Pixeljoch/Robocup_PCB/Robocup_PCB.csv

Id | Designator | Package | Quantity | Designation | Supplier and ref
1 | C1,C2,C3,C4,C5,C6,C7,C8,C9,C10,C11,C12 | C_1206_3216Metric_Pad1.42x1.75mm_HandSolder | 12 | 0.1uF
2 | C13 | C_1206_3216Metric_Pad1.42x1.75mm_HandSolder | 1 | 10n
3 | D1 | D_DO-201_P15.24mm_Horizontal | 1 | 1N5347B
4 | D2 | LED_0805_2012Metric_Pad1.15x1.40mm_HandSolder | 1 | GREEN
5 | D3 | LED_0805_2012Metric_Pad1.15x1.40mm_HandSolder | 1 | RED
6 | D4 | LED_0805_2012Metric_Pad1.15x1.40mm_HandSolder | 1 | BLUE
7 | IR1,IR2,IR3,IR4,IR5,IR6,IR7,IR8,IR9,IR10,IR11,IR12 | IR_TSOP93038_TH | 12 | TSSP93038
8 | J1 | PinSocket_1x06_P2.54mm_Vertical | 1 | M1_IN
9 | J2 | PinSocket_1x06_P2.54mm_Vertical | 1 | M2_IN
10 | J3 | PinSocket_1x06_P2.54mm_Vertical | 1 | M3_IN
11 | J4 | arduino_mega_header | 1 | Arduino_Mega_Header
12 | J8 | AMASS_XT60-M | 1 | XT60-M
13 | R1,R2,R3,R4,R5,R6,R7,R8,R9,R10,R11,R12 | R_1206_3216Metric_Pad1.42x1.75mm_HandSolder | 12 | 6k2
14 | R13 | R_1206_3216Metric_Pad1.42x1.75mm_HandSolder | 1 | 100k
15 | R14,R15 | R_1206_3216Metric_Pad1.42x1.75mm_HandSolder | 2 | 680R
16 | R16 | R_1206_3216Metric_Pad1.42x1.75mm_HandSolder | 1 | 180R
17 | SW_ARD,SW_M,SW_P | PinSocket_1x03_P2.54mm_Vertical | 3 | SS ESP101
18 | U1,U2,U5 | U_TB6612FNG_MOD | 3 | TB6612FNG_MOD
19 | U3 | 5V_D24V5F5_FP | 1 | 5V_D24V5F5
20 | U4 | 12_S18V20F12_FP | 1 | 12V_S18V20F12
21 | Q1 | TO-263-2 | 1 | IRF9540N
