Pixeljoch/Robocup_PCB/Main_Board/Main PCB outline.dxf

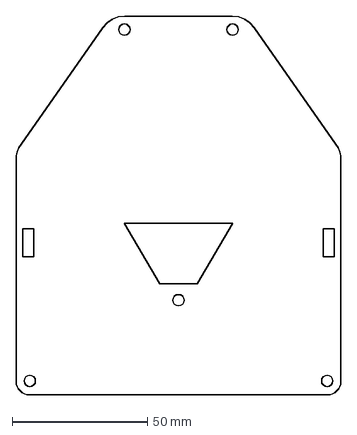
[picture p1: CAD file, 2022-02-05]
Main_Board/Main PCB outline.dxf
120.0 x 140.0 mm
