Pixeljoch/Robocup_PCB/3rd party libs/XT60-M.step

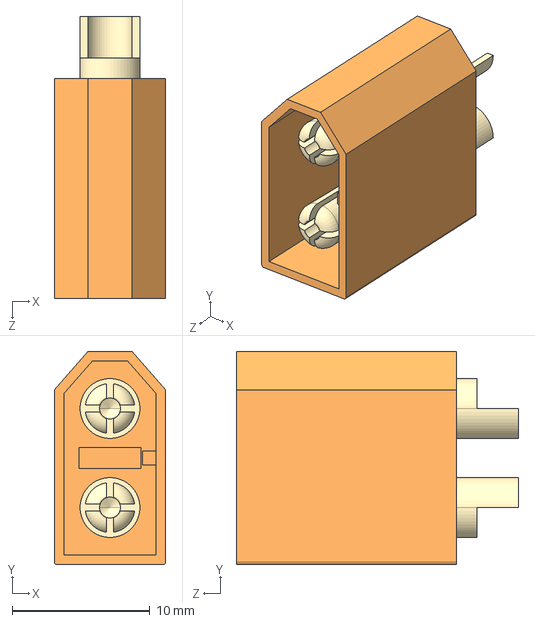
[picture p2: CAD file, 2021-01-07]
3rd party libs/XT60-M.step
8.10 x 15.5 x 20.5 mm
