Pixeljoch/Robocup_PCB/IR_Board/IR_Board.step

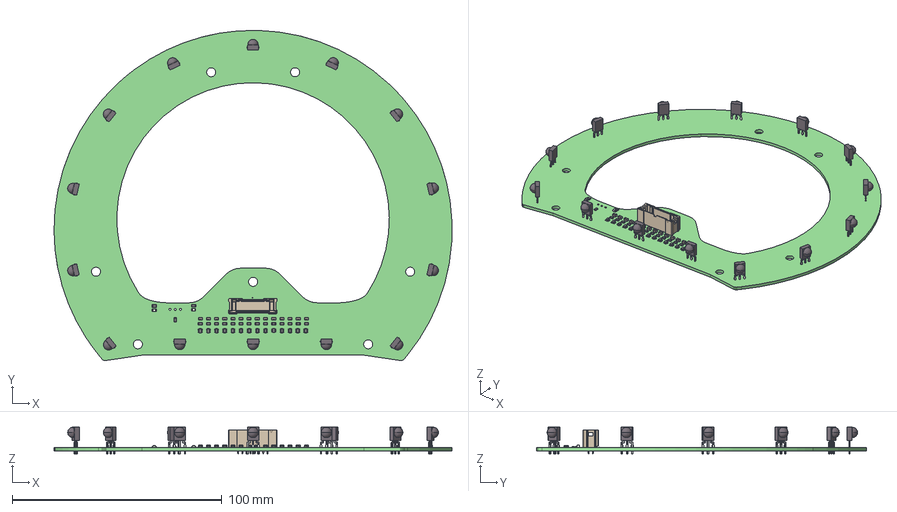
[picture p3: CAD file, 2022-02-22]
IR_Board/IR_Board.step
189.9 x 157.5 x 12.8 mm
IR_Board PCB
