Pixeljoch/Robocup_PCB/Light_Ring_PCB/Light_Ring_PCB.step

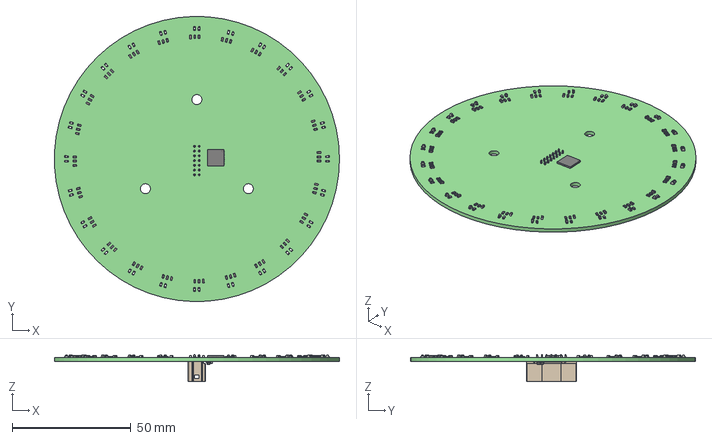
[picture p4: CAD file, 2022-02-01]
Light_Ring_PCB/Light_Ring_PCB.step
119.9 x 120.0 x 11.4 mm
