Pixeljoch/Robocup_PCB/sciencelab_logo.dxf

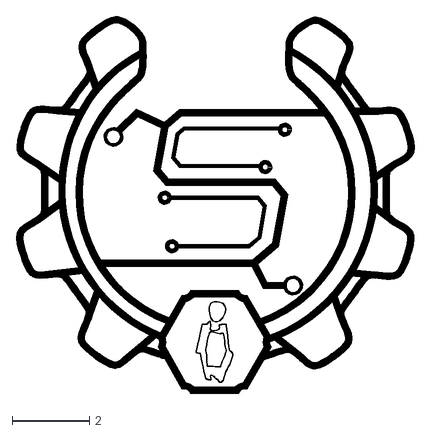
[picture p5: CAD file, 2022-01-30]
sciencelab_logo.dxf
10.3 x 9.77
