Pixeljoch/Robocup_PCB/3rd party libs/IRFR120ZTRPBF.step

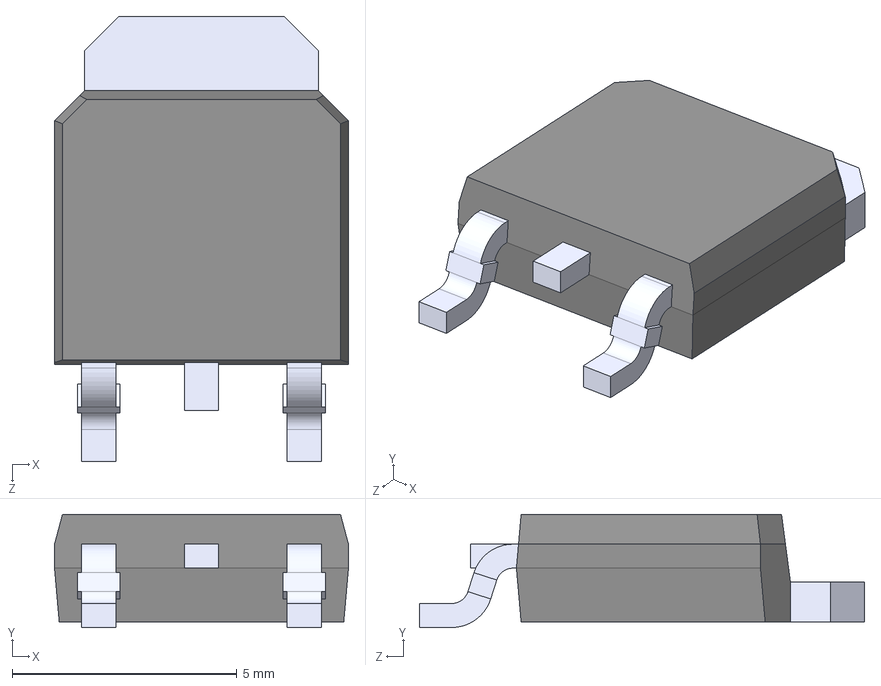
[picture p6: CAD file, 2021-01-07]
3rd party libs/IRFR120ZTRPBF.step
6.54 x 2.51 x 9.91 mm
