Pixeljoch/Robocup_PCB/IR_Board/IR PCB outline final.dxf

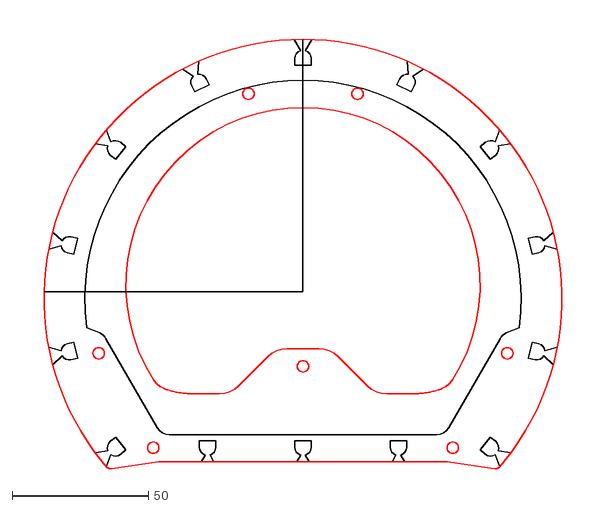
[picture p7: CAD file, 2022-02-11]
IR_Board/IR PCB outline final.dxf
210.4 x 166.1
