Pixeljoch/Robocup_PCB/Light_Ring_PCB/LightPCB outline.dxf

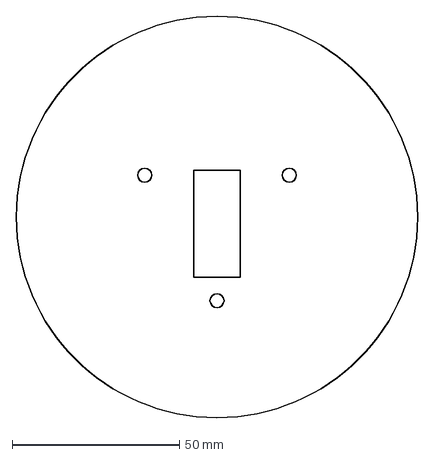
[picture p8: CAD file, 2022-01-28]
Light_Ring_PCB/LightPCB outline.dxf
120.0 x 120.0 mm
