Pixeljoch/Robocup_PCB/Light_Ring_PCB/voetbalrobotnieuwplaatv19.dxf

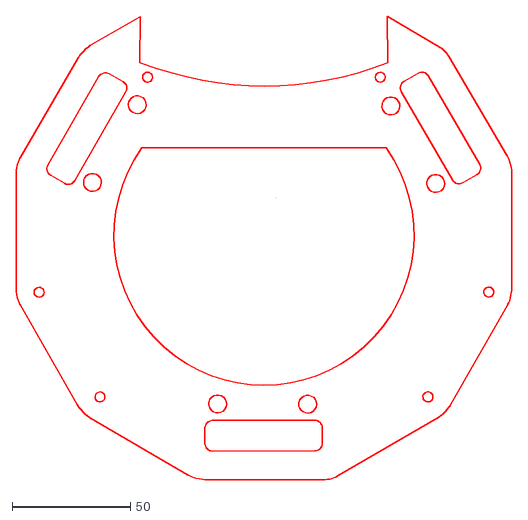
[picture p9: CAD file, 2021-04-22]
Light_Ring_PCB/voetbalrobotnieuwplaatv19.dxf
209.7 x 196.1
