Pixeljoch/Robocup_PCB/Light_Ring_PCB/Light_Ring_PCB.pdf

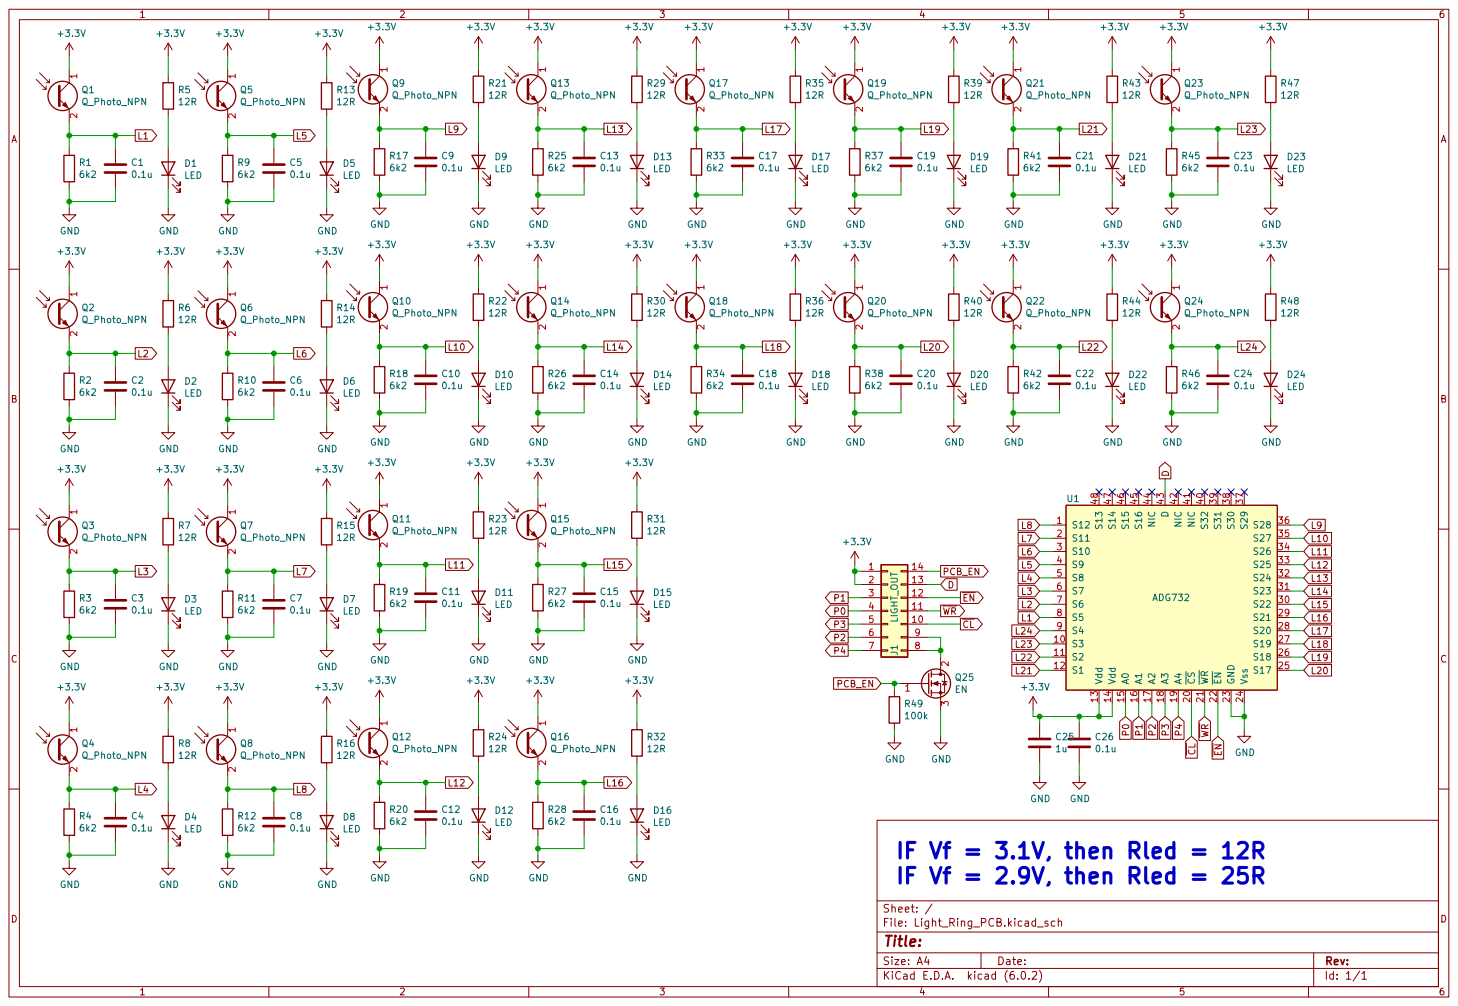
[picture p10: page 1]

IF Vf = 2.9V, then Rled = 25R
