Pixeljoch/Robocup_PCB/Main_Board/Main_Board.pdf

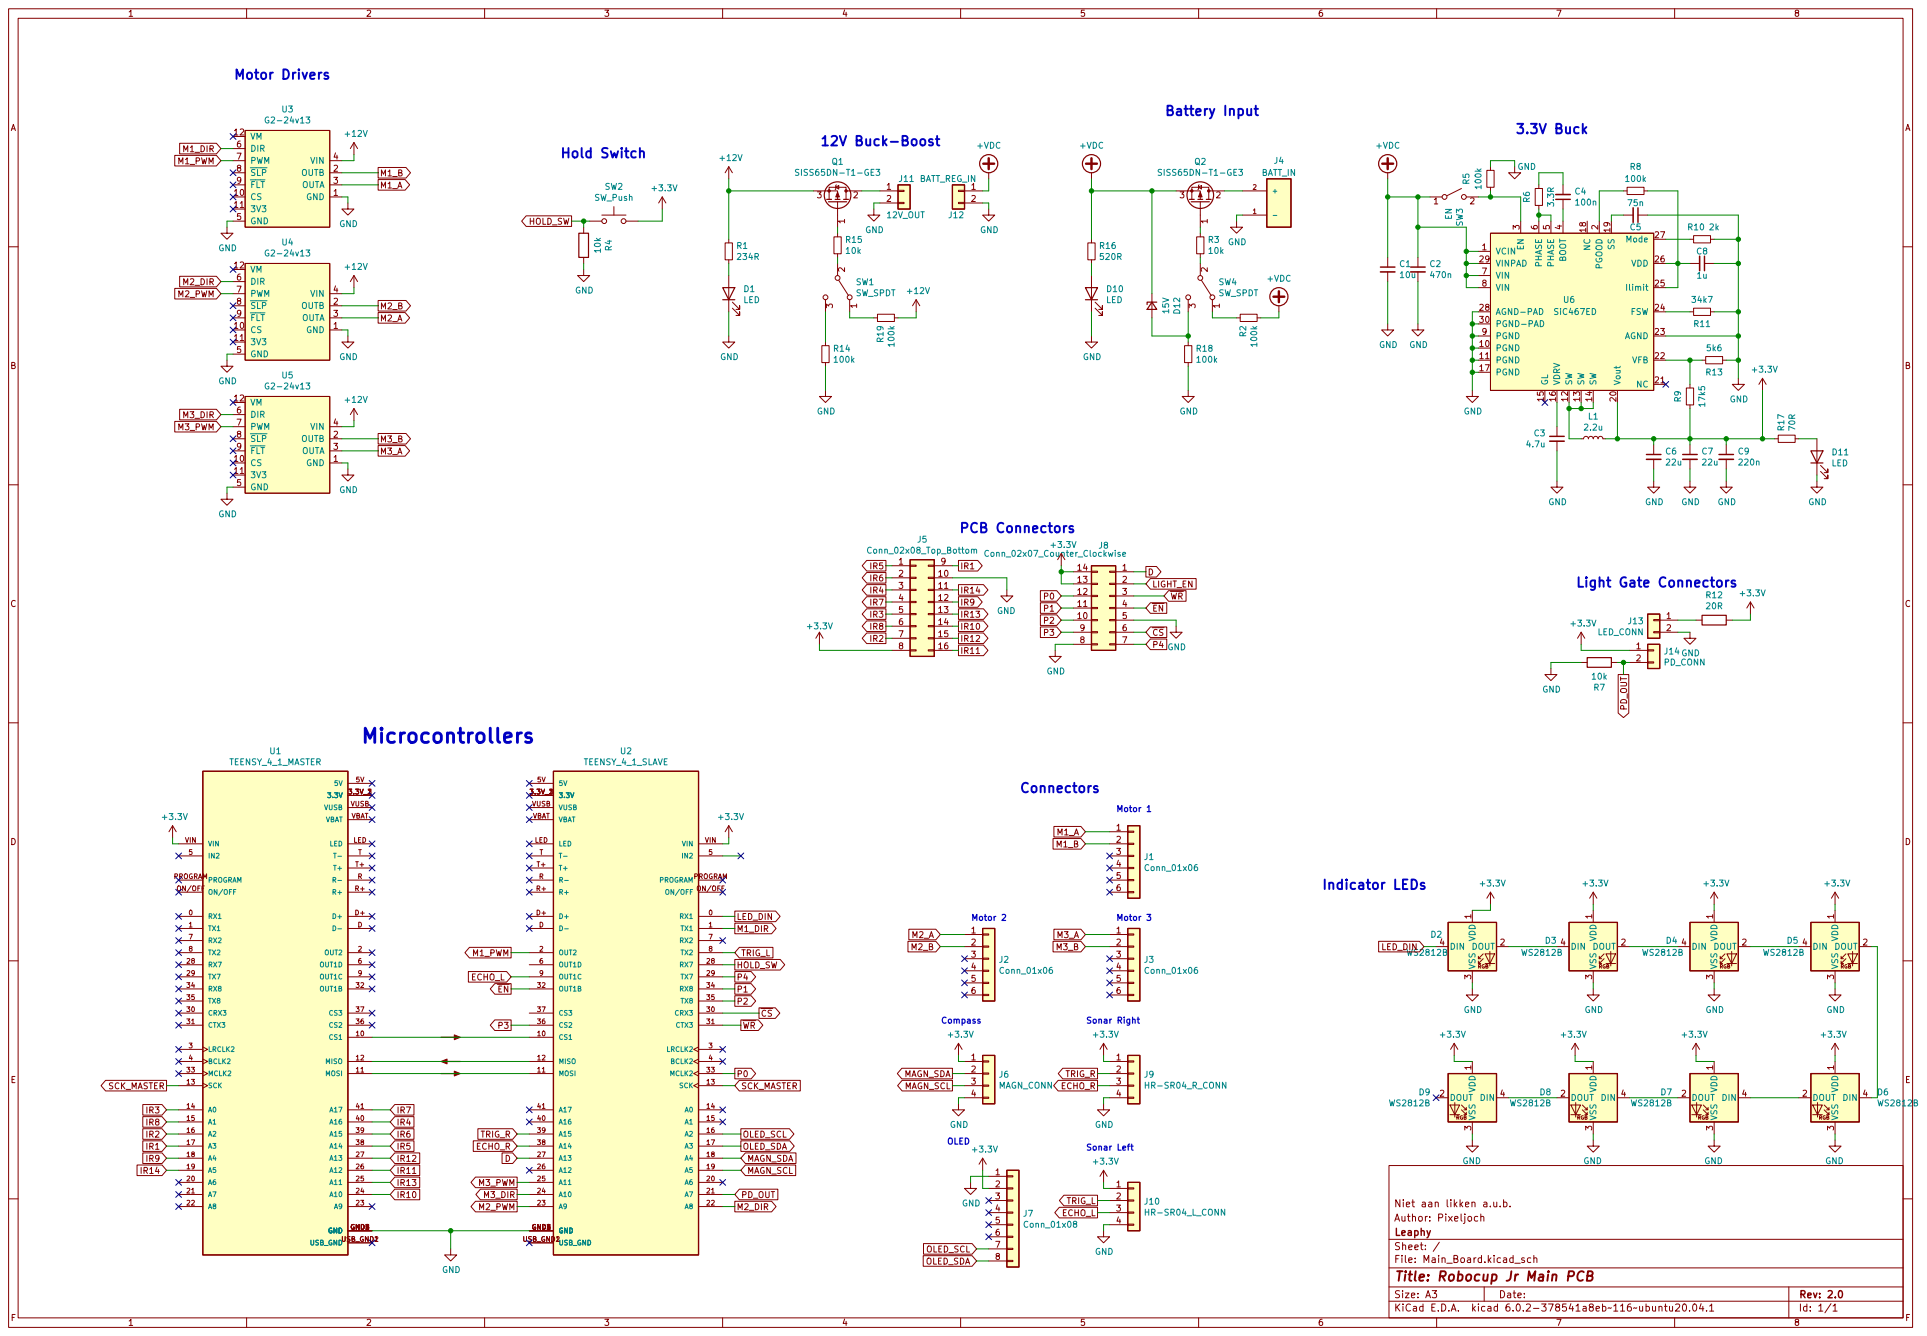
[picture p11: page 1]

Id: 1/1 Title: Robocup Jr Main PCB
