Pixeljoch/Robocup_PCB/IR_Board/IR_Board.kicad_pcb

## KiCad design IR_Board/IR_Board.kicad_pcb (2022-02-22)

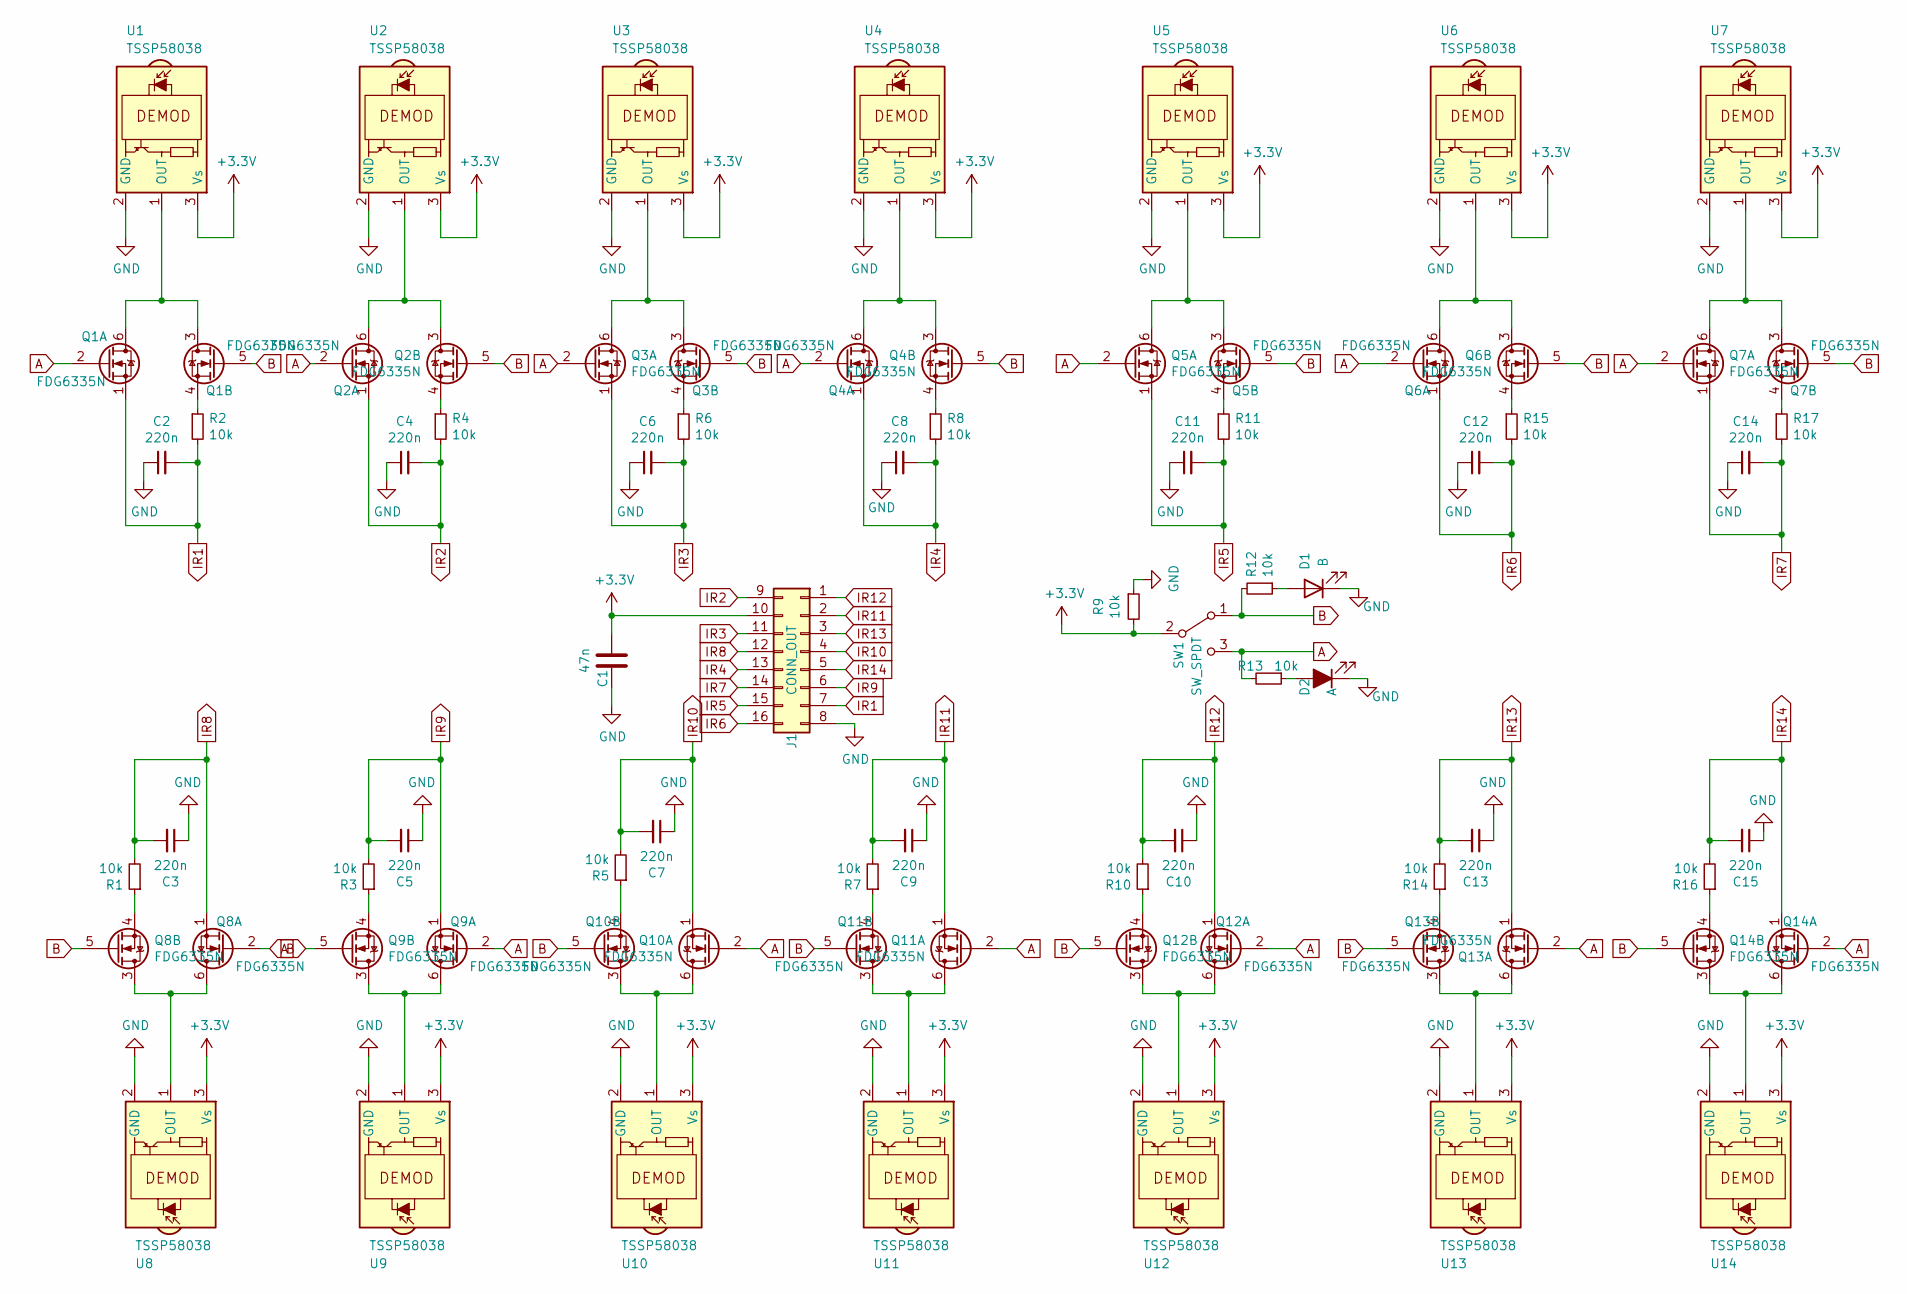
[picture p12: schematic IR_Board.kicad_sch, IR PCB Goaly]

Parts:
C1: 47n; C_0201_0603Metric
C2, C3, C4, C5, C6, C7, C8, C9, C10, C11, C12, C13, C14, C15: 220n; C_0805_2012Metric_Pad1.18x1.45mm_HandSolder
D1: B; LED_0805_2012Metric_Pad1.15x1.40mm_HandSolder
D2: A; LED_0805_2012Metric_Pad1.15x1.40mm_HandSolder
J1: CONN_OUT; Hirose_DF11-16DP-2DSA_2x08_P2.00mm_Vertical
Q1, Q2, Q3, Q4, Q5, Q6, Q7, Q8, Q9, Q10, Q11, Q12, Q13, Q14: FDG6335N; SOT-363_SC-70-6
R1, R2, R3, R4, R5, R6, R7, R8, R9, R10, R11, R12, R13, R14, R15, R16, R17: 10k; R_0805_2012Metric_Pad1.20x1.40mm_HandSolder
SW1: SW_SPDT; EG1218
U1, U2, U3, U4, U5, U6, U7, U8, U9, U10, U11, U12, U13, U14: TSSP58038; Vishay_MINIMOLD-3Pin

Connections:
+3V3: C1.2, J1.10, R9.2, SW1.2 (B), U1.3 (Vs), U2.3 (Vs), U3.3 (Vs), U4.3 (Vs), U5.3 (Vs), U6.3 (Vs), U7.3 (Vs), U8.3 (Vs), U9.3 (Vs), U10.3 (Vs), U11.3 (Vs), U12.3 (Vs), U13.3 (Vs), U14.3 (Vs)
A: Q1.2 (G), Q2.2 (G), Q3.2 (G), Q4.2 (G), Q5.2 (G), Q6.2 (G), Q7.2 (G), Q8.2 (G), Q9.2 (G), Q10.2 (G), Q11.2 (G), Q12.2 (G), Q13.2 (G), Q14.2 (G), R13.2, SW1.3 (C)
B: Q1.5 (G), Q2.5 (G), Q3.5 (G), Q4.5 (G), Q5.5 (G), Q6.5 (G), Q7.5 (G), Q8.5 (G), Q9.5 (G), Q10.5 (G), Q11.5 (G), Q12.5 (G), Q13.5 (G), Q14.5 (G), R12.2, SW1.1 (A)
GND: C1.1, C2.1, C3.1, C4.1, C5.1, C6.1, C7.1, C8.1, C9.1, C10.1, C11.1, C12.1, C13.1, C14.1, C15.1, D1.1 (K), D2.1 (K), J1.8, R9.1, U1.2 (GND), U2.2 (GND), U3.2 (GND), U4.2 (GND), U5.2 (GND), U6.2 (GND), U7.2 (GND), U8.2 (GND), U9.2 (GND), U10.2 (GND), U11.2 (GND), U12.2 (GND), U13.2 (GND), U14.2 (GND)
IR1: C2.2, J1.7, Q1.1 (S), R2.2
IR2: C4.2, J1.9, Q2.1 (S), R4.2
IR3: C6.2, J1.11, Q3.1 (S), R6.2
IR4: C8.2, J1.13, Q4.1 (S), R8.2
IR5: C11.2, J1.15, Q5.1 (S), R11.2
IR6: C12.2, J1.16, Q6.1 (S), R15.2
IR7: C14.2, J1.14, Q7.1 (S), R17.2
IR8: C3.2, J1.12, Q8.1 (S), R1.2
IR9: C5.2, J1.6, Q9.1 (S), R3.2
IR10: C7.2, J1.4, Q10.1 (S), R5.2
IR11: C9.2, J1.2, Q11.1 (S), R7.2
IR12: C10.2, J1.1, Q12.1 (S), R10.2
IR13: C13.2, J1.3, Q13.1 (S), R14.2
IR14: C15.2, J1.5, Q14.1 (S), R16.2
unnamed: D1.2 (A), R12.1
unnamed: D2.2 (A), R13.1
unnamed: Q1.3 (D), Q1.6 (D), U1.1 (OUT)
unnamed: Q1.4 (S), R2.1
unnamed: Q2.3 (D), Q2.6 (D), U2.1 (OUT)
unnamed: Q2.4 (S), R4.1
unnamed: Q3.3 (D), Q3.6 (D), U3.1 (OUT)
unnamed: Q3.4 (S), R6.1
unnamed: Q4.3 (D), Q4.6 (D), U4.1 (OUT)
unnamed: Q4.4 (S), R8.1
unnamed: Q5.3 (D), Q5.6 (D), U5.1 (OUT)
unnamed: Q5.4 (S), R11.1
unnamed: Q6.3 (D), Q6.6 (D), U6.1 (OUT)
unnamed: Q6.4 (S), R15.1
unnamed: Q7.3 (D), Q7.6 (D), U7.1 (OUT)
unnamed: Q7.4 (S), R17.1
unnamed: Q8.3 (D), Q8.6 (D), U8.1 (OUT)
unnamed: Q8.4 (S), R1.1
unnamed: Q9.3 (D), Q9.6 (D), U9.1 (OUT)
unnamed: Q9.4 (S), R3.1
unnamed: Q10.3 (D), Q10.6 (D), U10.1 (OUT)
unnamed: Q10.4 (S), R5.1
unnamed: Q11.3 (D), Q11.6 (D), U11.1 (OUT)
unnamed: Q11.4 (S), R7.1
unnamed: Q12.3 (D), Q12.6 (D), U12.1 (OUT)
unnamed: Q12.4 (S), R10.1
unnamed: Q13.3 (D), Q13.6 (D), U13.1 (OUT)
unnamed: Q13.4 (S), R14.1
unnamed: Q14.3 (D), Q14.6 (D), U14.1 (OUT)
unnamed: Q14.4 (S), R16.1

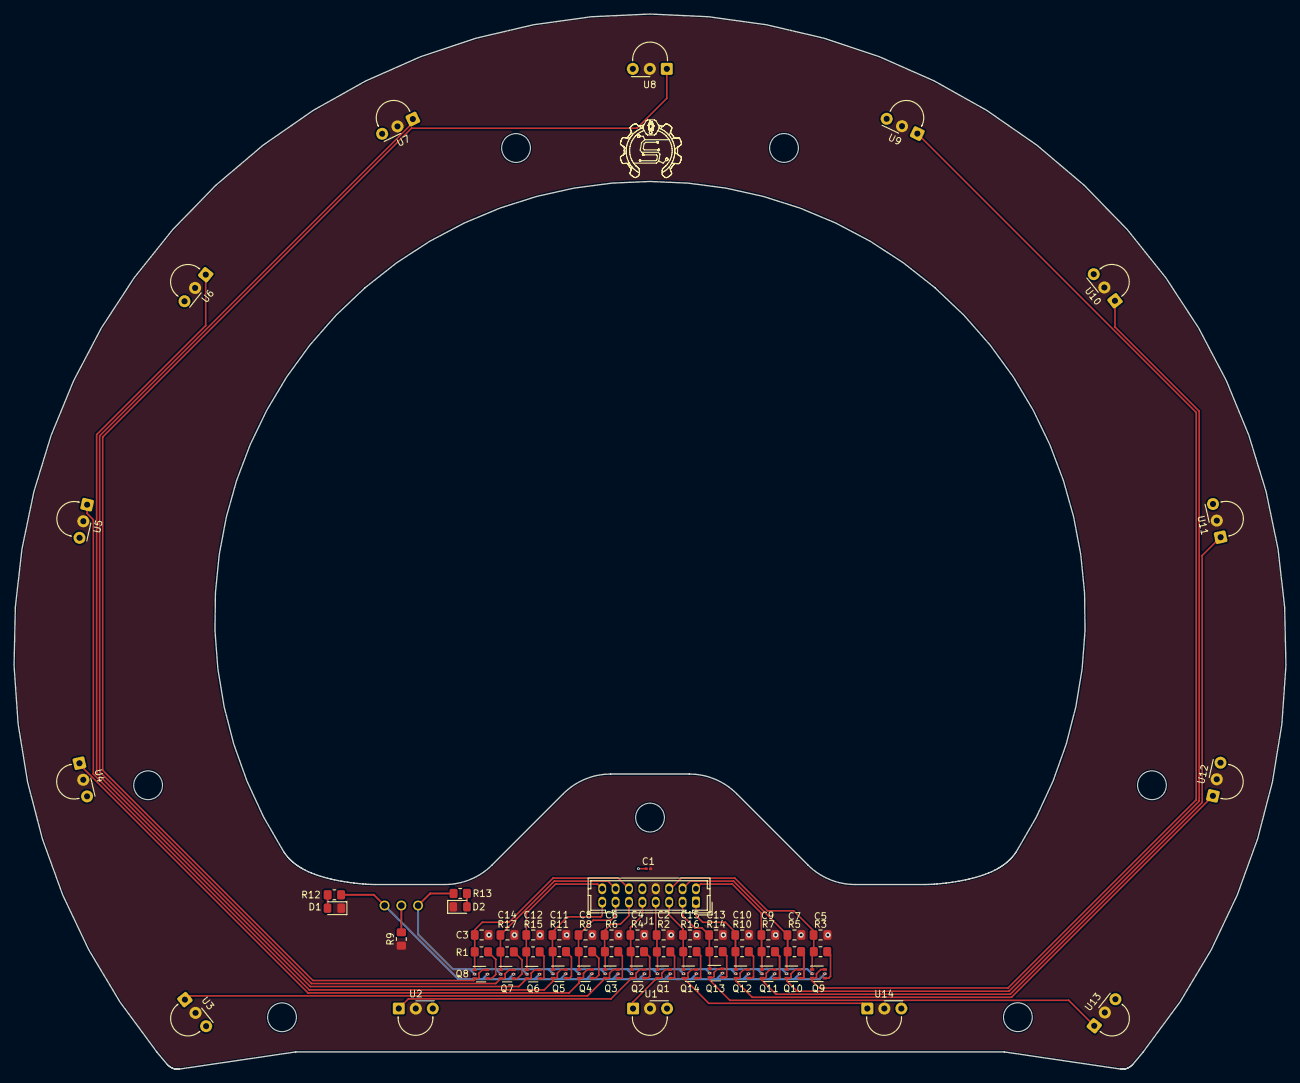
[picture p13: board IR_Board.kicad_pcb from above]

Board: 2 copper layers, 189.9 x 157.6 mm, 65 parts (1 on the bottom side), 48 nets.

Other parts of the board:
MH: MountingHole_4.3mm_M4
