Pixeljoch/Robocup_PCB/Main_Board/Main_Board.kicad_pcb

## KiCad design Main_Board/Main_Board.kicad_pcb (2022-02-16)

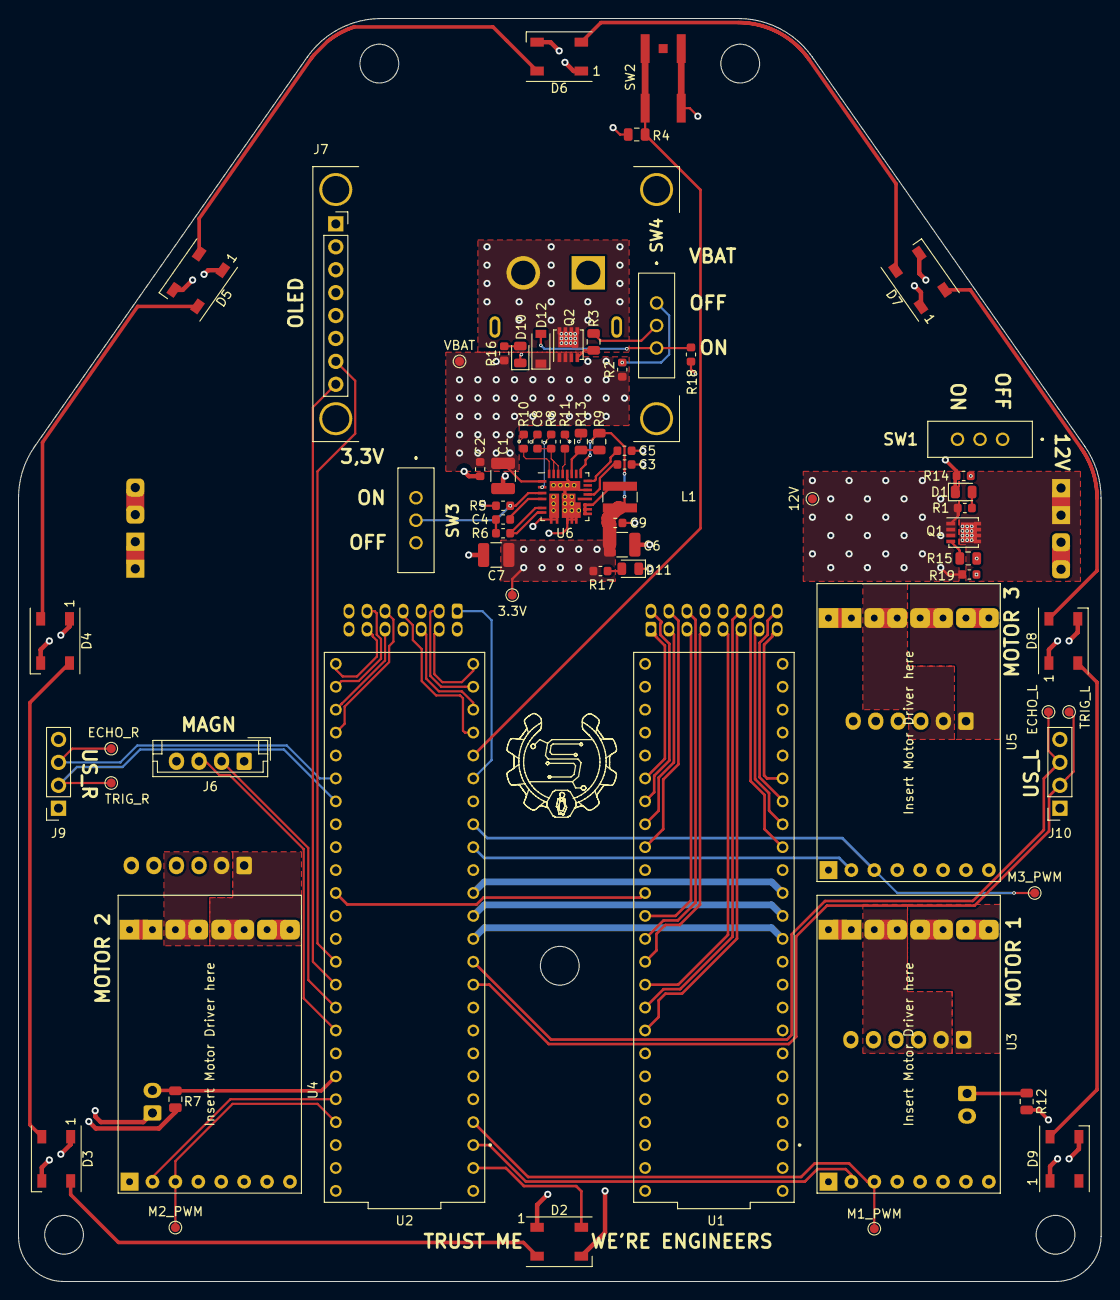
[picture p14: board Main_Board.kicad_pcb from above]

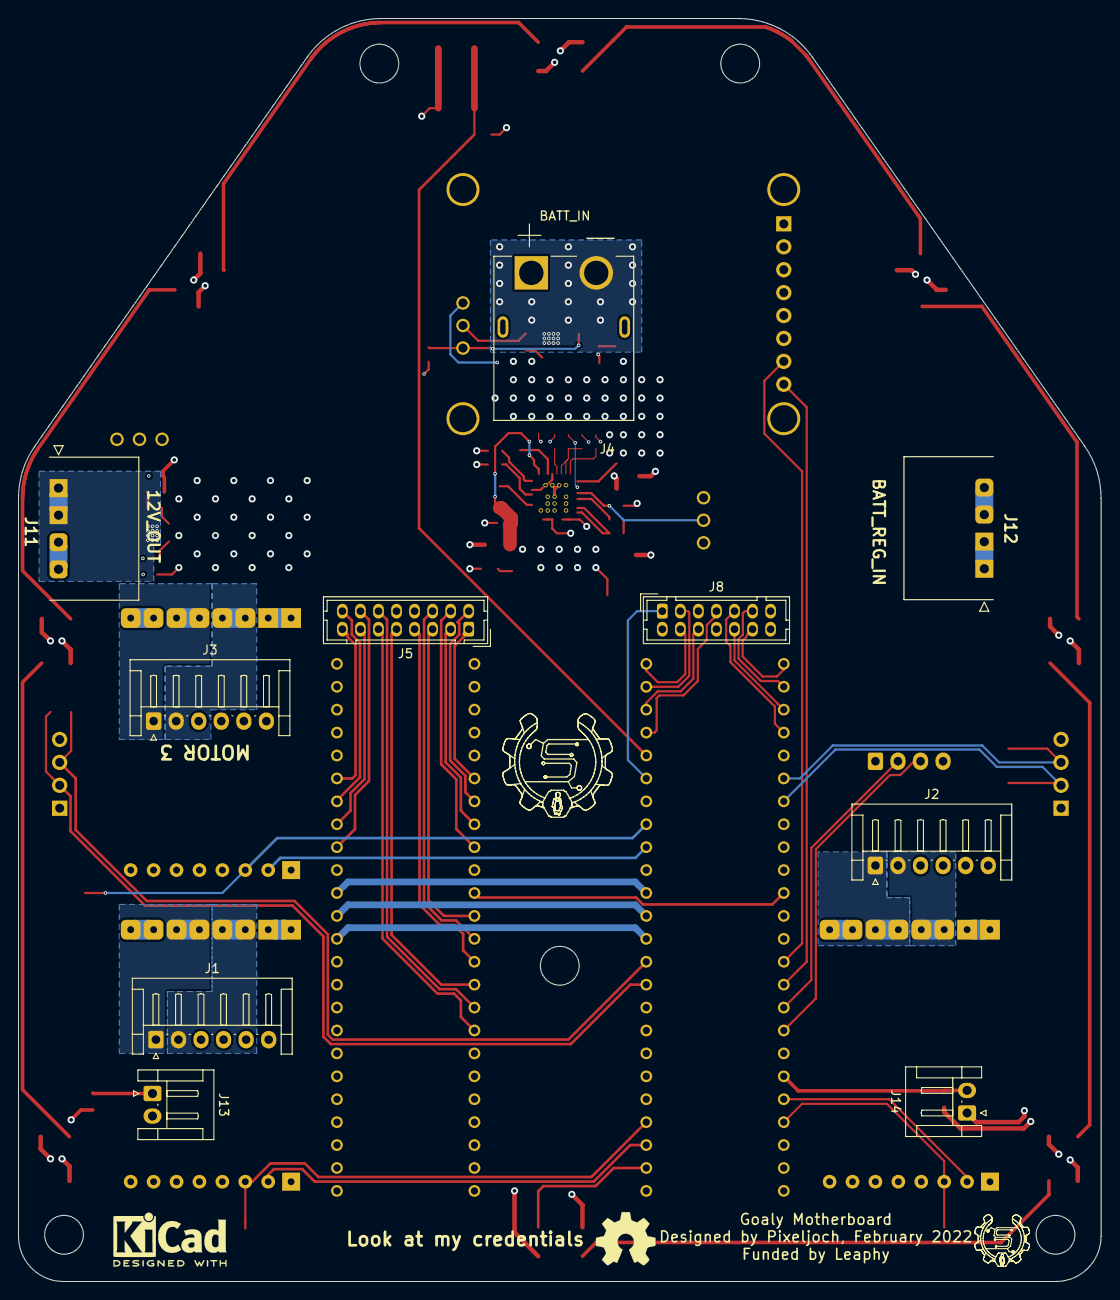
[picture p15: board Main_Board.kicad_pcb from below]

Board: 4 copper layers, 120.0 x 140.0 mm, 79 parts (10 on the bottom side), 87 nets.

Parts:
3.3V, 12V: TestPoint_Pad_D1.0mm
C1: 10u; C_1210_3225Metric
C2: 470n; C_0603_1608Metric
C3: 4.7u; C_0603_1608Metric
C4: 100n; C_0603_1608Metric
C5: 75n; C_0603_1608Metric
C6, C7: 22u; C_1210_3225Metric
C8: 1u; C_0603_1608Metric
C9: 220n; C_0603_1608Metric
D1, D10, D11: LED; LED_0805_2012Metric
D2, D3, D4, D5, D6, D7, D8, D9: WS2812B; LED_WS2812B_PLCC4_5.0x5.0mm_P3.2mm
D12: 20V; D_SOD-123
ECHO_L: TestPoint_Pad_D1.0mm
ECHO_R: TestPoint_Pad_D1.0mm
J1, J2, J3: Conn_01x06; JST_EH_S6B-EH_1x06_P2.50mm_Horizontal
J4: BATT_IN; AMASS_XT60PW-M
J5: Conn_02x08_Top_Bottom; Hirose_DF11-16DP-2DSA_2x08_P2.00mm_Vertical
J6: MAGN_CONN; JST_EH_B4B-EH-A_1x04_P2.50mm_Vertical
J7: Conn_01x08; PinSocket_1x08_P2.54mm_Vertical
J8: Conn_02x07_Counter_Clockwise; Hirose_DF11-14DP-2DSA_2x07_P2.00mm_Vertical
J9: HR-SR04_R_CONN; PinSocket_1x04_P2.54mm_Vertical
J10: HR-SR04_L_CONN; PinSocket_1x04_P2.54mm_Vertical
J11: 12V_OUT; 215760-YY04
J12: BATT_REG_IN; 215760-YY04
J13: LED_CONN; JST_EH_S2B-EH_1x02_P2.50mm_Horizontal
J14: PD_CONN; JST_EH_S2B-EH_1x02_P2.50mm_Horizontal
L1: 2.2u; Bours_SRP4020FA
M1_PWM, M2_PWM, M3_PWM: TestPoint_Pad_D1.0mm
M4, M4#2: MountingHole_4.3mm_M4
Q1, Q2: SISS65DN-T1-GE3; Vishay_PowerPAK_1212-8_Single
R1: 234R; R_0603_1608Metric
R2, R5, R8, R14, R18, R19: 100k; R_0603_1608Metric
R3, R4, R7, R15: 10k; R_0805_2012Metric
R6: 3.3R; R_0603_1608Metric
R9: 17k5; R_0805_2012Metric
R10: 2k; R_0603_1608Metric
R11: 34k7; R_0603_1608Metric
R12: 20R; R_0805_2012Metric
R13: 5k6; R_0805_2012Metric
R16: 520R; R_0603_1608Metric
R17: 70R; R_0603_1608Metric
SW1, SW4: SW_SPDT; EG1218
SW2: SW_Push; EVP-BT2J4A000
SW3: EN; EG1218
TRIG_L: TestPoint_Pad_D1.0mm
TRIG_R: TestPoint_Pad_D1.0mm
U1: TEENSY_4_1_MASTER; TEENSY_4_1_FP
U2: TEENSY_4_1_SLAVE; TEENSY_4_1_FP
U3, U4, U5: G2-24v13
U6: SiC467ED; Vishay_PowerPAK_MLP55-27L_ThermalVias
VBAT: TestPoint_Pad_D1.0mm

Connections:
+3V3: 3.3V.1, C6.1, C7.1, C9.1, D2.1 (VDD), D3.1 (VDD), D4.1 (VDD), D5.1 (VDD), D6.1 (VDD), D7.1 (VDD), D8.1 (VDD), D9.1 (VDD), J5.8, J6.1, J7.2, J8.13, J8.14, J9.1, J10.1, J14.1, L1.2, R9.1, R12.2, R17.1, SW2.2, U1.VIN, U2.VIN, U6.20 (Vout)
+12V: Q1.3 (S), R1.1, R19.2, U3.4 (VIN), U4.4 (VIN), U5.4 (VIN)
+VDC: C1.1, C2.1, D12.1 (K), J12.1, Q2.3 (S), R2.2, R16.1, SW3.1 (A), U6.1 (VCIN), U6.7 (VIN), U6.8 (VIN), U6.29 (VINPAD), VBAT.1
D: J8.1, U2.27 (A13)
ECHO_L: ECHO_L.1, J10.3, U2.9 (OUT1C)
ECHO_R: ECHO_R.1, J9.3, U2.38 (A14)
GND: C1.2, C2.2, C3.2, C5.1, C6.2, C7.2, C8.1, C9.2, D1.1 (K), D2.3 (VSS), D3.3 (VSS), D4.3 (VSS), D5.3 (VSS), D6.3 (VSS), D7.3 (VSS), D8.3 (VSS), D9.3 (VSS), D10.1 (K), D11.1 (K), J4.1 (-), J5.10, J6.4, J7.1, J8.5, J8.8, J9.4, J10.4, J11.2, J12.2, J13.2, R4.1, R5.2, R7.1, R10.1, R11.1, R13.1, R14.2, R18.2, U1.GND1 (GND), U1.GND2 (GND), U1.GND3 (GND), U2.GND1 (GND), U2.GND2 (GND), U2.GND3 (GND), U3.1 (GND), U3.5 (GND), U4.1 (GND), U4.5 (GND), U5.1 (GND), U5.5 (GND), U6.9 (PGND), U6.10 (PGND), U6.11 (PGND), U6.17 (PGND), U6.23 (AGND), U6.28 (AGND-PAD), U6.30 (PGND-PAD)
HOLD_SW: R4.2, SW2.1, U2.28 (RX7)
IR1: J5.9, U1.17 (A3)
IR2: J5.7, U1.16 (A2)
IR3: J5.5, U1.14 (A0)
IR4: J5.3, U1.40 (A16)
IR5: J5.1, U1.38 (A14)
IR6: J5.2, U1.39 (A15)
IR7: J5.4, U1.41 (A17)
IR8: J5.6, U1.15 (A1)
IR9: J5.12, U1.18 (A4)
IR10: J5.14, U1.24 (A10)
IR11: J5.16, U1.26 (A12)
IR12: J5.15, U1.27 (A13)
IR13: J5.13, U1.25 (A11)
IR14: J5.11, U1.19 (A5)
LED_DIN: D2.4 (DIN), U2.0 (RX1)
M1_A: J1.1, U3.3 (OUTA)
M1_B: J1.2, U3.2 (OUTB)
M1_DIR: U2.1 (TX1), U3.6 (DIR)
M1_PWM: M1_PWM.1, U2.2 (OUT2), U3.7 (PWM)
M2_A: J2.1, U4.3 (OUTA)
M2_B: J2.2, U4.2 (OUTB)
M2_DIR: U2.22 (A8), U4.6 (DIR)
M2_PWM: M2_PWM.1, U2.23 (A9), U4.7 (PWM)
M3_A: J3.1, U5.3 (OUTA)
M3_B: J3.2, U5.2 (OUTB)
M3_DIR: U2.24 (A10), U5.6 (DIR)
M3_PWM: M3_PWM.1, U2.25 (A11), U5.7 (PWM)
MAGN_SCL: J6.3, U2.19 (A5)
MAGN_SDA: J6.2, U2.18 (A4)
unnamed: C3.1, U6.16 (VDRV)
unnamed: C4.1, U6.4 (BOOT)
unnamed: C4.2, R6.2
unnamed: C5.2, U6.19 (SS)
unnamed: C8.2, R8.1, U6.25 (Ilimit), U6.26 (VDD)
unnamed: D1.2 (A), R1.2
unnamed: D2.2 (DOUT), D3.4 (DIN)
unnamed: D3.2 (DOUT), D4.4 (DIN)
unnamed: D4.2 (DOUT), D5.4 (DIN)
unnamed: D5.2 (DOUT), D6.4 (DIN)
unnamed: D6.2 (DOUT), D7.4 (DIN)
unnamed: D7.2 (DOUT), D8.4 (DIN)
unnamed: D8.2 (DOUT), D9.4 (DIN)
unnamed: D10.2 (A), R16.2
unnamed: D11.2 (A), R17.2
unnamed: D12.2 (A), R18.1, SW4.3 (C)
unnamed: J4.2 (+), Q2.2 (D)
unnamed: J11.1, Q1.2 (D)
unnamed: J13.1, R12.1
unnamed: L1.1, U6.12 (SW), U6.13 (SW), U6.14 (SW)
unnamed: Q1.1 (G), R15.1
unnamed: Q2.1 (G), R3.1
unnamed: R2.1, SW4.1 (A)
unnamed: R3.2, SW4.2 (B)
unnamed: R5.1, SW3.2 (B), U6.3 (EN)
unnamed: R6.1, U6.5 (PHASE), U6.6 (PHASE)
unnamed: R8.2, U6.2 (PGOOD)
unnamed: R10.2, U6.27 (Mode)
unnamed: R11.2, U6.24 (FSW)
unnamed: R9.2, R13.2, U6.22 (VFB)
unnamed: R14.1, SW1.3 (C)
unnamed: R15.2, SW1.2 (B)
unnamed: R19.1, SW1.1 (A)
unnamed: U1.10 (CS1), U2.10 (CS1)
unnamed: U1.11 (MOSI), U2.11 (MOSI)
unnamed: U1.12 (MISO), U2.12 (MISO)
OLED_SCL: J7.7, U2.16 (A2)
OLED_SDA: J7.8, U2.17 (A3)
P0: J8.12, U2.33 (MCLK2)
P1: J8.11, U2.34 (RX8)
P2: J8.10, U2.35 (TX8)
P3: J8.9, U2.36 (CS2)
P4: J8.7, U2.29 (TX7)
PD_OUT: J14.2, R7.2, U2.21 (A7)
SCK_MASTER: U1.13 (SCK), U2.13 (SCK)
TRIG_L: J10.2, TRIG_L.1, U2.8 (TX2)
TRIG_R: J9.2, TRIG_R.1, U2.39 (A15)
~CS: J8.6, U2.30 (CRX3)
~EN: J8.4, U2.32 (OUT1B)
~WR: J8.3, U2.31 (CTX3)
