Pixeljoch/Robocup_PCB/Light_Ring_PCB/Light_Ring_PCB.kicad_pcb

## KiCad design Light_Ring_PCB/Light_Ring_PCB.kicad_pcb (2022-02-13)

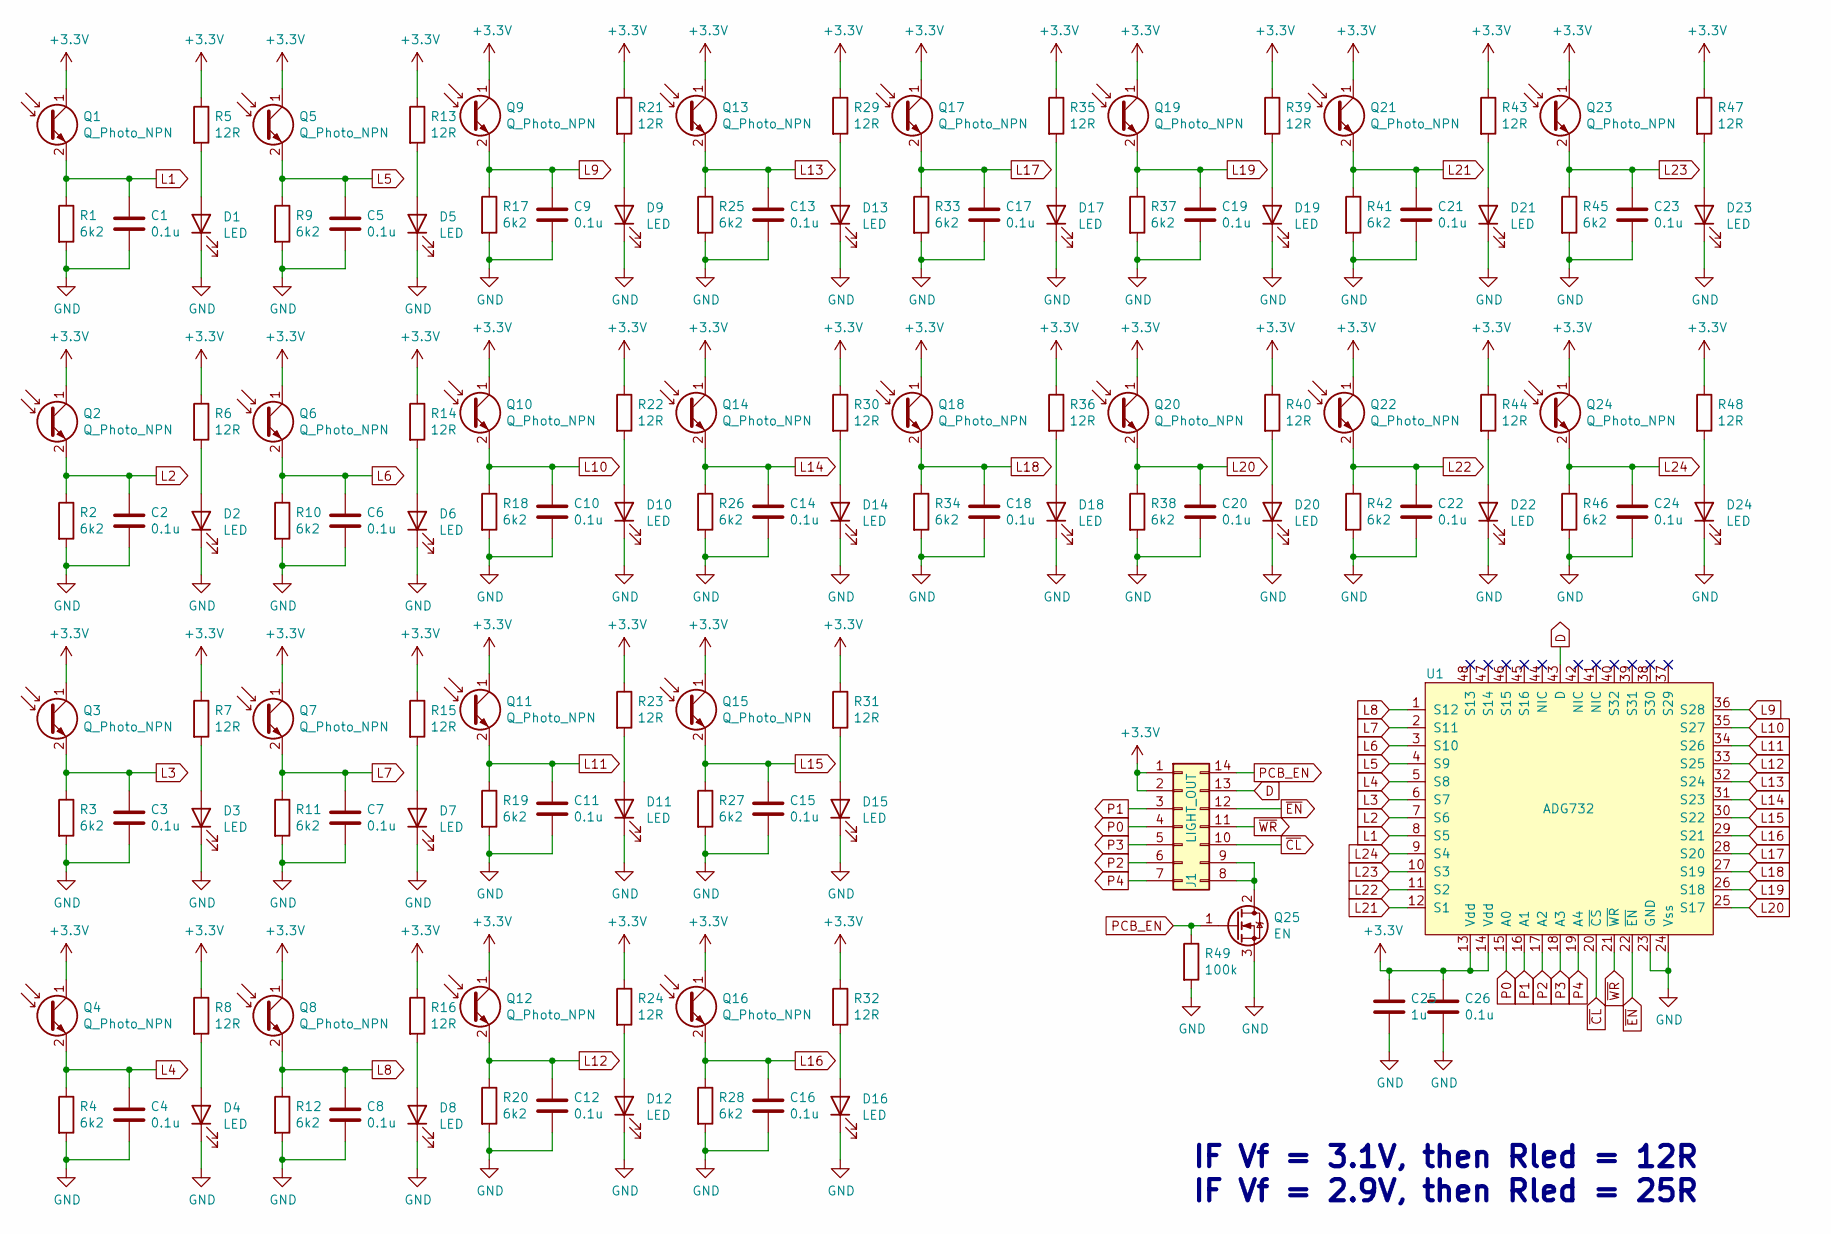
[picture p16: schematic Light_Ring_PCB.kicad_sch]

Parts:
C1, C2, C3, C4, C5, C6, C7, C8, C9, C10, C11, C12, C13, C14, C15, C16, C17, C18, C19, C20, C21, C22, C23, C24, C26: 0.1u; C_0603_1608Metric_Pad1.08x0.95mm_HandSolder
C25: 1u; C_0603_1608Metric_Pad1.08x0.95mm_HandSolder
D1, D2, D3, D4, D5, D6, D7, D8, D9, D10, D11, D12, D13, D14, D15, D16, D17, D18, D19, D20, D21, D22, D23, D24: LED; LED_0603_1608Metric
J1: LIGHT_OUT; Hirose_DF11-14DP-2DSA_2x07_P2.00mm_Vertical
Q1, Q2, Q3, Q4, Q5, Q6, Q7, Q8, Q9, Q10, Q11, Q12, Q13, Q14, Q15, Q16, Q17, Q18, Q19, Q20, Q21, Q22, Q23, Q24: Q_Photo_NPN; XDCR_ALS-PT19-315C_L177_TR8
Q25: EN; SOT-23
R1, R2, R3, R4, R9, R10, R11, R12, R17, R18, R19, R20, R25, R26, R27, R28, R33, R34, R37, R38, R41, R42, R45, R46: 6k2; R_0603_1608Metric_Pad0.98x0.95mm_HandSolder
R5, R6, R7, R8, R13, R14, R15, R16, R21, R22, R23, R24, R29, R30, R31, R32, R35, R36, R39, R40, R43, R44, R47, R48: 12R; R_0603_1608Metric_Pad0.98x0.95mm_HandSolder
R49: 100k; R_0603_1608Metric_Pad0.98x0.95mm_HandSolder
U1: ADG732; LFCSP-48-1EP_7x7mm_P0.5mm_EP4.1x4.1mm

Connections:
+3V3: C25.1, C26.1, J1.1, J1.2, Q1.1 (C), Q2.1 (C), Q3.1 (C), Q4.1 (C), Q5.1 (C), Q6.1 (C), Q7.1 (C), Q8.1 (C), Q9.1 (C), Q10.1 (C), Q11.1 (C), Q12.1 (C), Q13.1 (C), Q14.1 (C), Q15.1 (C), Q16.1 (C), Q17.1 (C), Q18.1 (C), Q19.1 (C), Q20.1 (C), Q21.1 (C), Q22.1 (C), Q23.1 (C), Q24.1 (C), R5.1, R6.1, R7.1, R8.1, R13.1, R14.1, R15.1, R16.1, R21.1, R22.1, R23.1, R24.1, R29.1, R30.1, R31.1, R32.1, R35.1, R36.1, R39.1, R40.1, R43.1, R44.1, R47.1, R48.1, U1.13 (Vdd), U1.14 (Vdd)
D: J1.13, U1.43 (D)
GND: C1.2, C2.2, C3.2, C4.2, C5.2, C6.2, C7.2, C8.2, C9.2, C10.2, C11.2, C12.2, C13.2, C14.2, C15.2, C16.2, C17.2, C18.2, C19.2, C20.2, C21.2, C22.2, C23.2, C24.2, C25.2, C26.2, D1.1 (K), D2.1 (K), D3.1 (K), D4.1 (K), D5.1 (K), D6.1 (K), D7.1 (K), D8.1 (K), D9.1 (K), D10.1 (K), D11.1 (K), D12.1 (K), D13.1 (K), D14.1 (K), D15.1 (K), D16.1 (K), D17.1 (K), D18.1 (K), D19.1 (K), D20.1 (K), D21.1 (K), D22.1 (K), D23.1 (K), D24.1 (K), Q25.3 (S), R1.2, R2.2, R3.2, R4.2, R9.2, R10.2, R11.2, R12.2, R17.2, R18.2, R19.2, R20.2, R25.2, R26.2, R27.2, R28.2, R33.2, R34.2, R37.2, R38.2, R41.2, R42.2, R45.2, R46.2, R49.2, U1.23 (GND), U1.24 (Vss), U1.49
L1: C1.1, Q1.2 (E), R1.1, U1.8 (S5)
L2: C2.1, Q2.2 (E), R2.1, U1.7 (S6)
L3: C3.1, Q3.2 (E), R3.1, U1.6 (S7)
L4: C4.1, Q4.2 (E), R4.1, U1.5 (S8)
L5: C5.1, Q5.2 (E), R9.1, U1.4 (S9)
L6: C6.1, Q6.2 (E), R10.1, U1.3 (S10)
L7: C7.1, Q7.2 (E), R11.1, U1.2 (S11)
L8: C8.1, Q8.2 (E), R12.1, U1.1 (S12)
L9: C9.1, Q9.2 (E), R17.1, U1.36 (S28)
L10: C10.1, Q10.2 (E), R18.1, U1.35 (S27)
L11: C11.1, Q11.2 (E), R19.1, U1.34 (S26)
L12: C12.1, Q12.2 (E), R20.1, U1.33 (S25)
L13: C13.1, Q13.2 (E), R25.1, U1.32 (S24)
L14: C14.1, Q14.2 (E), R26.1, U1.31 (S23)
L15: C15.1, Q15.2 (E), R27.1, U1.30 (S22)
L16: C16.1, Q16.2 (E), R28.1, U1.29 (E)
L17: C17.1, Q17.2 (E), R33.1, U1.28 (S20)
L18: C18.1, Q18.2 (E), R34.1, U1.27 (S19)
L19: C19.1, Q19.2 (E), R37.1, U1.26 (S18)
L20: C20.1, Q20.2 (E), R38.1, U1.25 (S17)
L21: C21.1, Q21.2 (E), R41.1, U1.12 (S1)
L22: C22.1, Q22.2 (E), R42.1, U1.11 (S2)
L23: C23.1, Q23.2 (E), R45.1, U1.10 (S3)
L24: C24.1, Q24.2 (E), R46.1, U1.9 (S4)
unnamed: D1.2 (A), R5.2
unnamed: D2.2 (A), R6.2
unnamed: D3.2 (A), R7.2
unnamed: D4.2 (A), R8.2
unnamed: D5.2 (A), R13.2
unnamed: D6.2 (A), R14.2
unnamed: D7.2 (A), R15.2
unnamed: D8.2 (A), R16.2
unnamed: D9.2 (A), R21.2
unnamed: D10.2 (A), R22.2
unnamed: D11.2 (A), R23.2
unnamed: D12.2 (A), R24.2
unnamed: D13.2 (A), R29.2
unnamed: D14.2 (A), R30.2
unnamed: D15.2 (A), R31.2
unnamed: D16.2 (A), R32.2
unnamed: D17.2 (A), R35.2
unnamed: D18.2 (A), R36.2
unnamed: D19.2 (A), R39.2
unnamed: D20.2 (A), R40.2
unnamed: D21.2 (A), R43.2
unnamed: D22.2 (A), R44.2
unnamed: D23.2 (A), R47.2
unnamed: D24.2 (A), R48.2
unnamed: J1.8, J1.9, Q25.2 (D)
P0: J1.4, U1.15 (A0)
P1: J1.3, U1.16 (A1)
P2: J1.6, U1.17 (A2)
P3: J1.5, U1.18 (A3)
P4: J1.7, U1.19 (A4)
PCB_EN: J1.14, Q25.1 (G), R49.1
~CL: J1.10, U1.20 (~CS)
~EN: J1.12, U1.22 (~EN)
~WR: J1.11, U1.21 (~WR)

Notes on the sheet:
IF Vf = 3.1V, then Rled = 12R IF Vf = 2.9V, then Rled = 25R

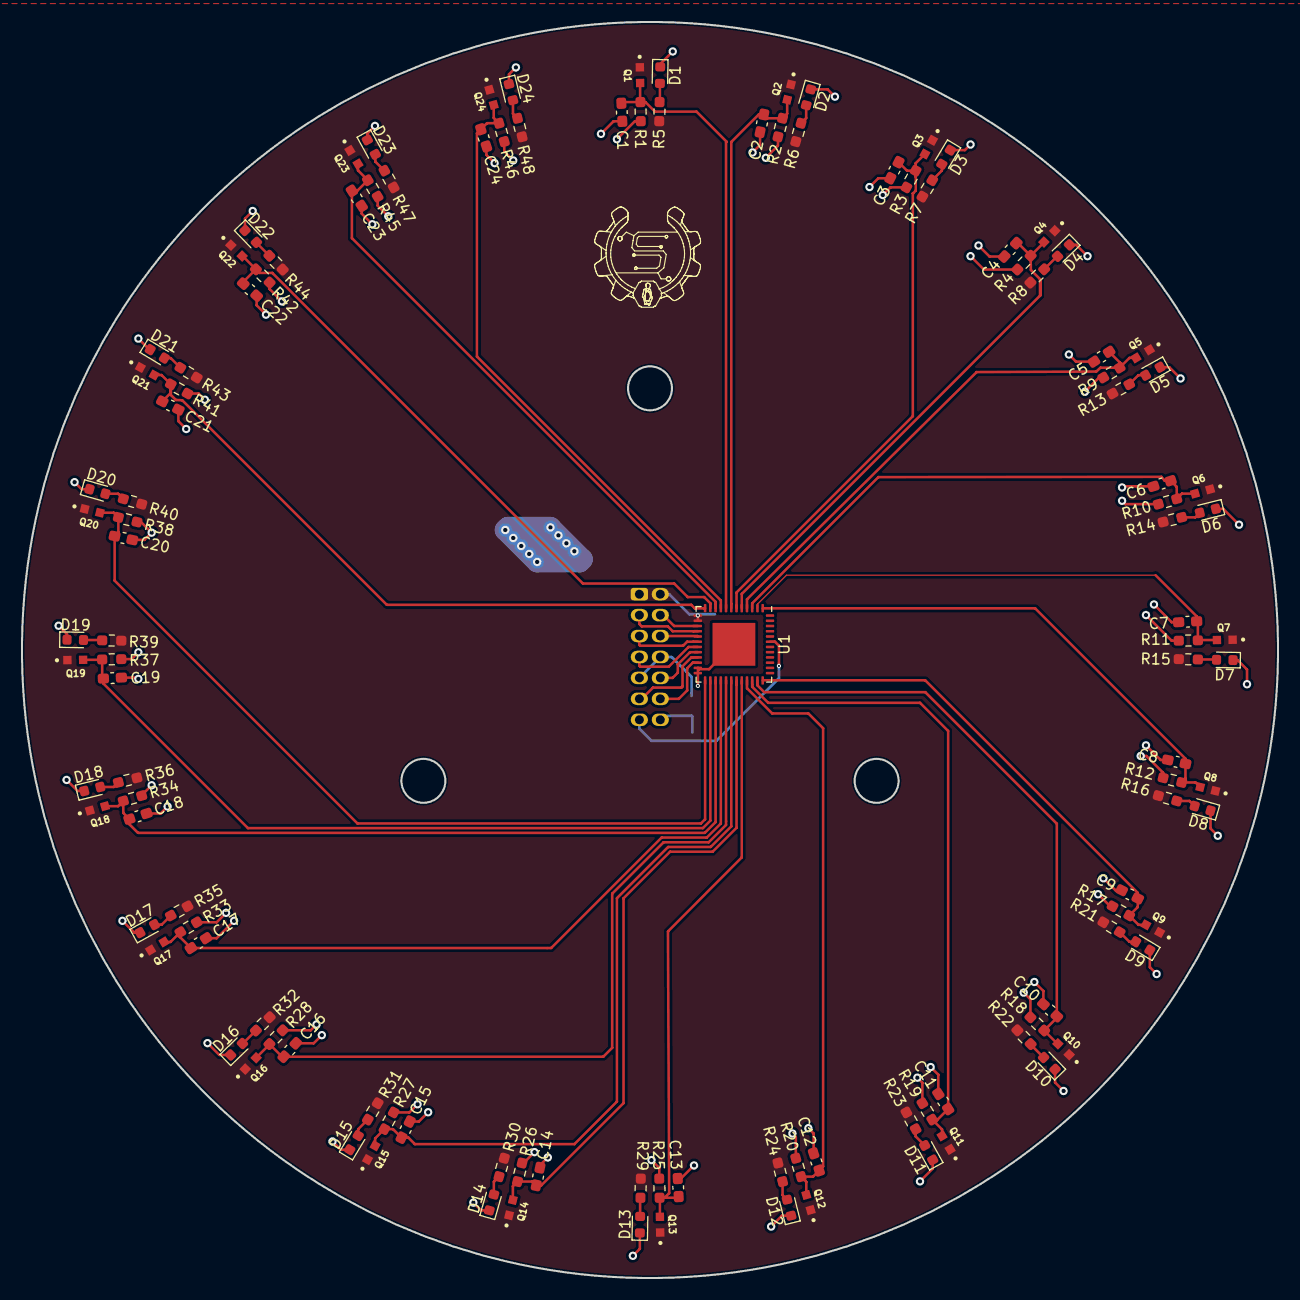
[picture p17: board Light_Ring_PCB.kicad_pcb from above]

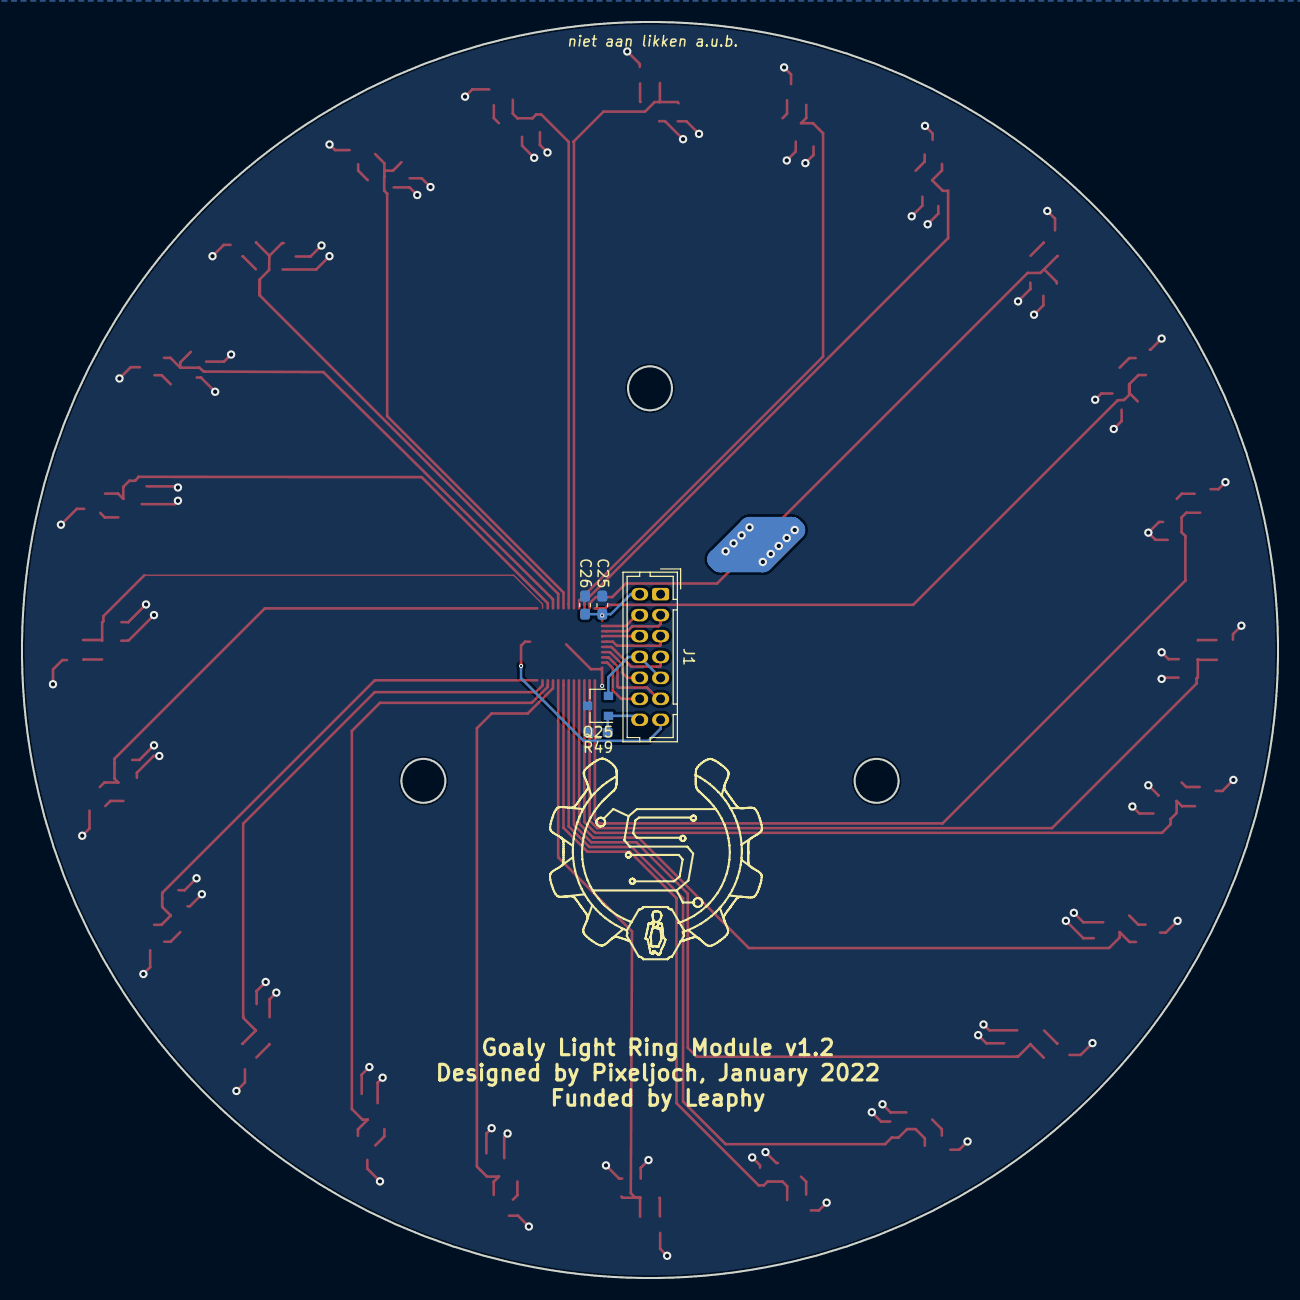
[picture p18: board Light_Ring_PCB.kicad_pcb from below]

Board: 2 copper layers, 120.0 x 120.0 mm, 126 parts (5 on the bottom side), 61 nets.
