Pixeljoch/Robocup_PCB/LiPo_12_Driver/LiPo_12_Driver.kicad_pcb

## KiCad design LiPo_12_Driver/LiPo_12_Driver.kicad_pcb (2021-11-09)

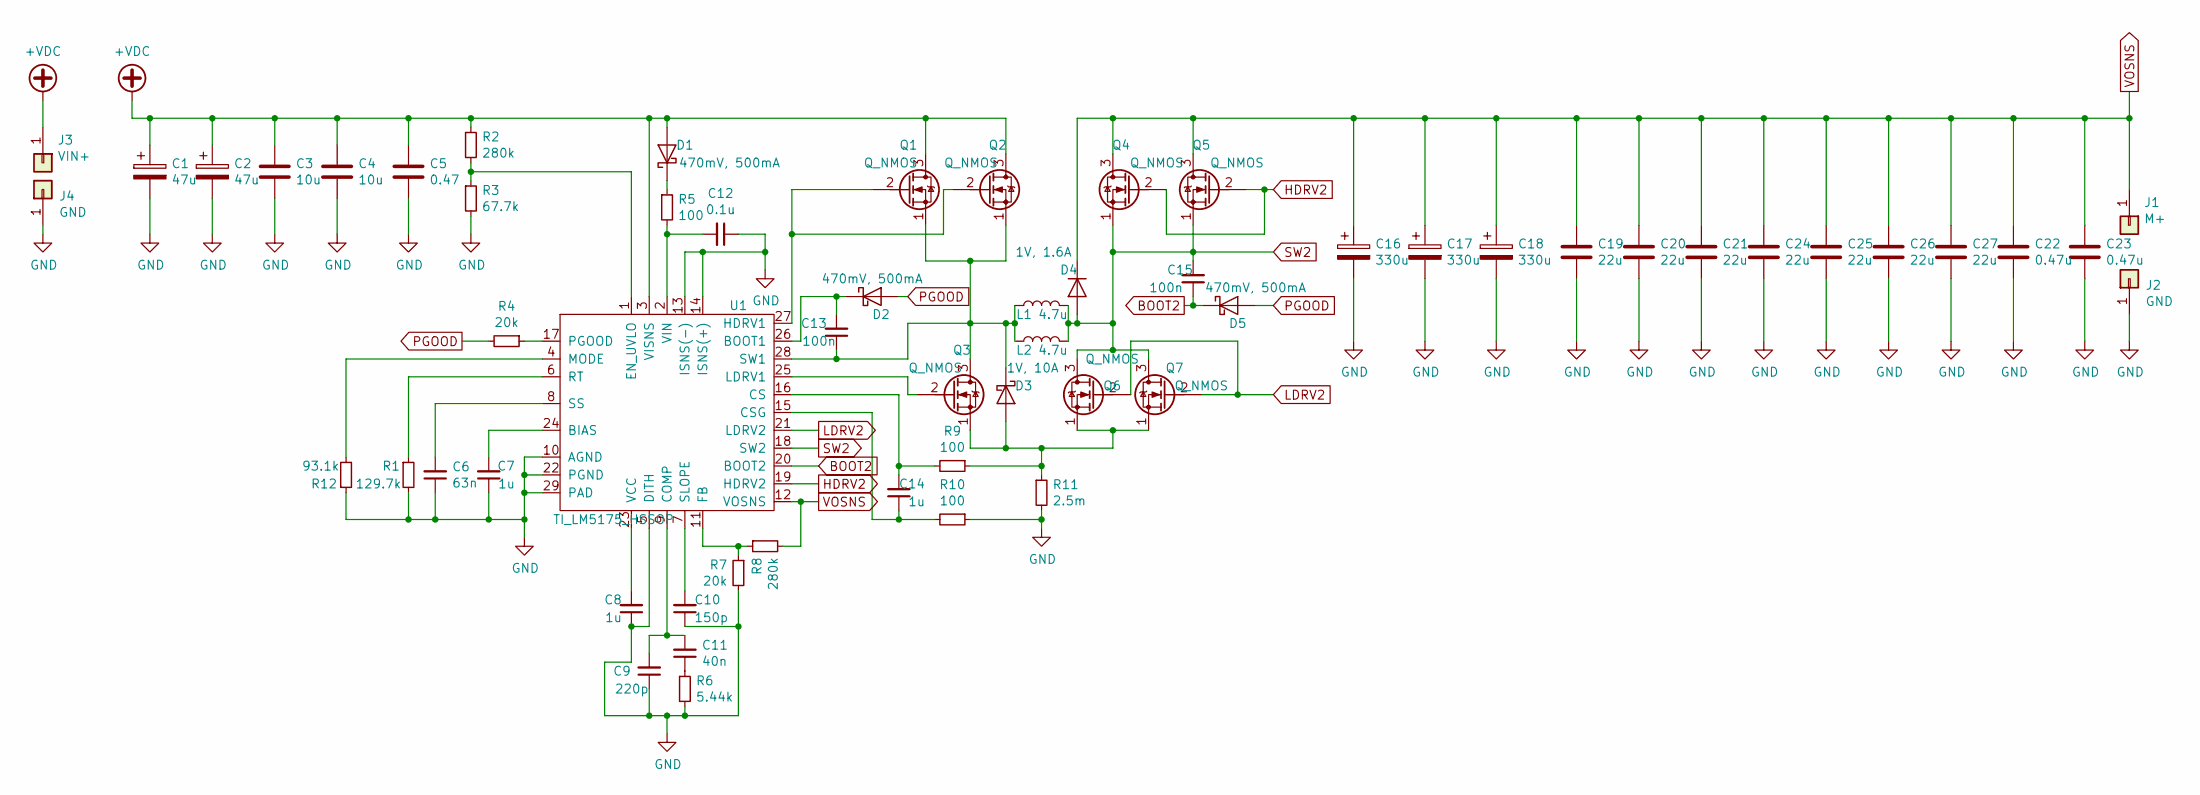
[picture p19: schematic 20A_Version.sch]

Parts:
C1, C2: 47u; CP_Elec_6.3x7.7
C3, C4: 10u; C_1210_3225Metric_Pad1.42x2.65mm_HandSolder
C5: 0.47; C_0603_1608Metric_Pad1.05x0.95mm_HandSolder
C6: 63n; C_0603_1608Metric_Pad1.05x0.95mm_HandSolder
C7, C8, C14: 1u; C_0805_2012Metric_Pad1.15x1.40mm_HandSolder
C9: 220p; C_0603_1608Metric_Pad1.05x0.95mm_HandSolder
C10: 150p; C_0603_1608Metric_Pad1.05x0.95mm_HandSolder
C11: 40n; C_0603_1608Metric_Pad1.05x0.95mm_HandSolder
C12: 0.1u; C_0603_1608Metric_Pad1.05x0.95mm_HandSolder
C13: 100n; C_0603_1608Metric_Pad1.05x0.95mm_HandSolder
C15: 100n; C_0805_2012Metric_Pad1.15x1.40mm_HandSolder
C16, C17, C18: 330u; CP_Elec_6.3x9.9
C19, C20, C21, C24, C25, C26, C27: 22u; C_1210_3225Metric_Pad1.42x2.65mm_HandSolder
C22, C23: 0.47u; C_0603_1608Metric_Pad1.05x0.95mm_HandSolder
D1, D2, D5: 470mV, 500mA; D_SOD-123
D3: 1V, 10A; TO-252-2
D4: 1V, 1.6A; D_SMA_Handsoldering
J1: M+; PinHeader_1x01_P2.54mm_Vertical
J2, J4: GND; PinHeader_1x01_P2.54mm_Vertical
J3: VIN+; PinHeader_1x01_P2.54mm_Vertical
L1, L2: 4.7u; L_Vishay_IHLP-6767
Q1, Q2, Q3: Q_NMOS; VSONP-8-1EP_5x6_P1.27mm
Q4, Q5, Q6, Q7: Q_NMOS; VSON-8_3.3x3.3mm_P0.65mm_NexFET
R1: 129.7k; R_0402_1005Metric
R2: 280k; R_0402_1005Metric
R3: 67.7k; R_0402_1005Metric
R4, R7: 20k; R_0603_1608Metric_Pad1.05x0.95mm_HandSolder
R5, R9, R10: 100; R_0603_1608Metric_Pad1.05x0.95mm_HandSolder
R6: 5.44k; R_0402_1005Metric
R8: 280k; R_0603_1608Metric_Pad1.05x0.95mm_HandSolder
R11: 2.5m; R_2816_7142Metric_Pad3.20x4.45mm_HandSolder
R12: 93.1k; R_0603_1608Metric_Pad1.05x0.95mm_HandSolder
U1: TI_LM5175_HSSOP; HTSSOP-28-1EP_4.4x9.7mm_P0.65mm_EP3.4x9.5mm_ThermalVias

Connections:
+VDC: C1.1, C2.1, C3.1, C4.1, C5.1, D1.2 (A), J3.1, Q1.3 (D), Q2.3 (D), R2.1, U1.3 (VISNS)
BOOT2: C15.1, D5.1 (K), U1.20 (BOOT2)
GND: C1.2, C2.2, C3.2, C4.2, C5.2, C6.1, C7.1, C8.1, C9.1, C10.1, C12.1, C16.2, C17.2, C18.2, C19.2, C20.2, C21.2, C22.2, C23.2, C24.2, C25.2, C26.2, C27.2, J2.1, J4.1, R1.2, R3.2, R6.2, R7.2, R10.1, R11.2, R12.1, U1.5 (DITH), U1.10 (AGND), U1.13 (ISNS(-)), U1.14 (ISNS(+)), U1.22 (PGND), U1.29 (PAD)
HDRV2: Q4.2 (G), Q5.2 (G), U1.19 (HDRV2)
LDRV2: Q6.2 (G), Q7.2 (G), U1.21 (LDRV2)
unnamed: C6.2, U1.8 (SS)
unnamed: C7.2, U1.24 (BIAS)
unnamed: C8.2, U1.23 (VCC)
unnamed: C10.2, U1.7 (SLOPE)
unnamed: C11.1, R6.1
unnamed: C9.2, C11.2, U1.9 (COMP)
unnamed: C12.2, R5.2, U1.2 (VIN)
unnamed: C13.1, D3.1 (K), L1.1, L2.1, Q1.1 (S), Q2.1 (S), Q3.3 (D), U1.28 (SW1)
unnamed: C13.2, D2.1 (K), U1.26 (BOOT1)
unnamed: C14.1, R10.2, U1.15 (CSG)
unnamed: C14.2, R9.2, U1.16 (CS)
unnamed: D1.1 (K), R5.1
unnamed: D3.2 (A), Q3.1 (S), Q6.1 (S), Q7.1 (S), R9.1, R11.1
unnamed: Q1.2 (G), Q2.2 (G), U1.27 (HDRV1)
unnamed: Q3.2 (G), U1.25 (LDRV1)
unnamed: R1.1, U1.6 (RT)
unnamed: R2.2, R3.1, U1.1 (EN_UVLO)
unnamed: R4.1, U1.17 (PGOOD)
unnamed: R7.1, R8.1, U1.11 (FB)
unnamed: R12.2, U1.4 (MODE)
PGOOD: D2.2 (A), D5.2 (A), R4.2
SW2: C15.2, D4.2 (A), L1.2, L2.2, Q4.1 (S), Q5.1 (S), Q6.3 (D), Q7.3 (D), U1.18 (SW2)
VOSNS: C16.1, C17.1, C18.1, C19.1, C20.1, C21.1, C22.1, C23.1, C24.1, C25.1, C26.1, C27.1, D4.1 (K), J1.1, Q4.3 (D), Q5.3 (D), R8.2, U1.12 (VOSNS)

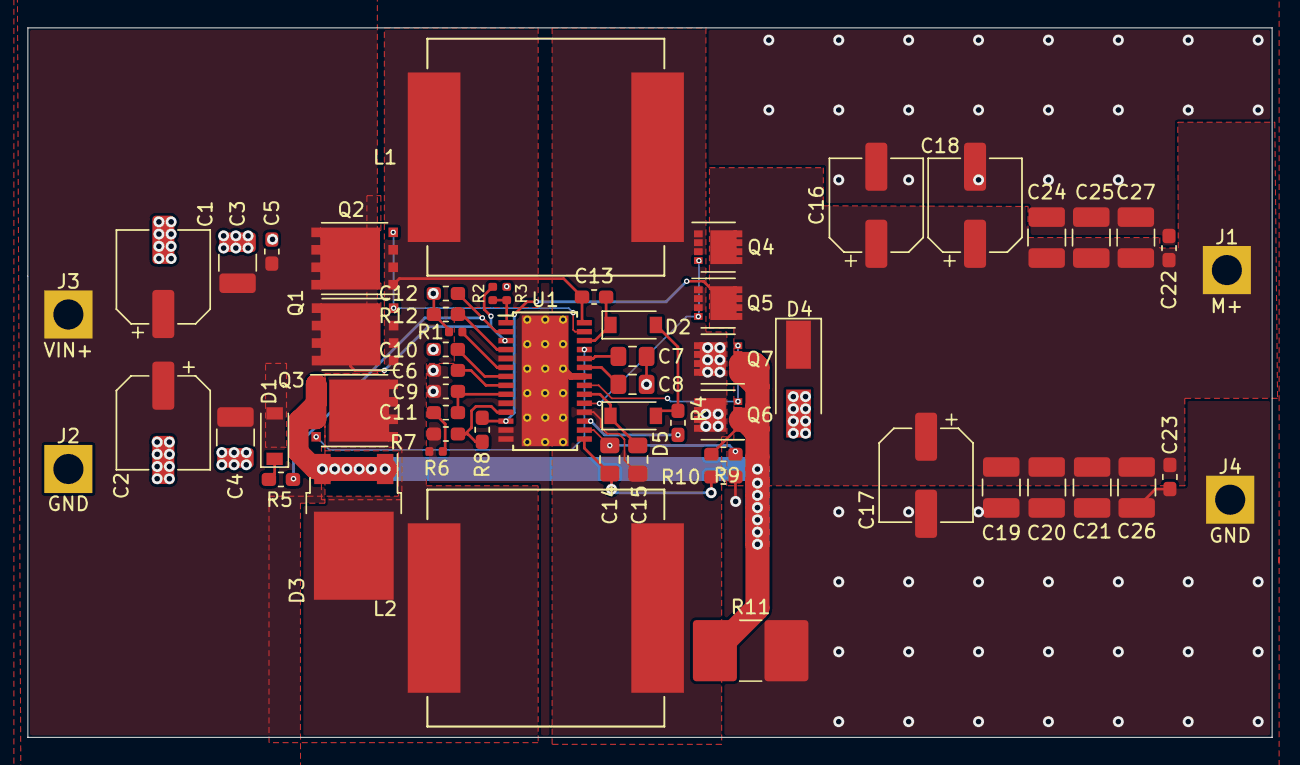
[picture p20: board LiPo_12_Driver.kicad_pcb from above]

Board: 2 copper layers, 90.4 x 51.6 mm, 58 parts (0 on the bottom side), 28 nets.
