Pixeljoch/Robocup_PCB/Robocup_PCB.kicad_pcb

## KiCad design Robocup_PCB.kicad_pcb (2021-03-11)

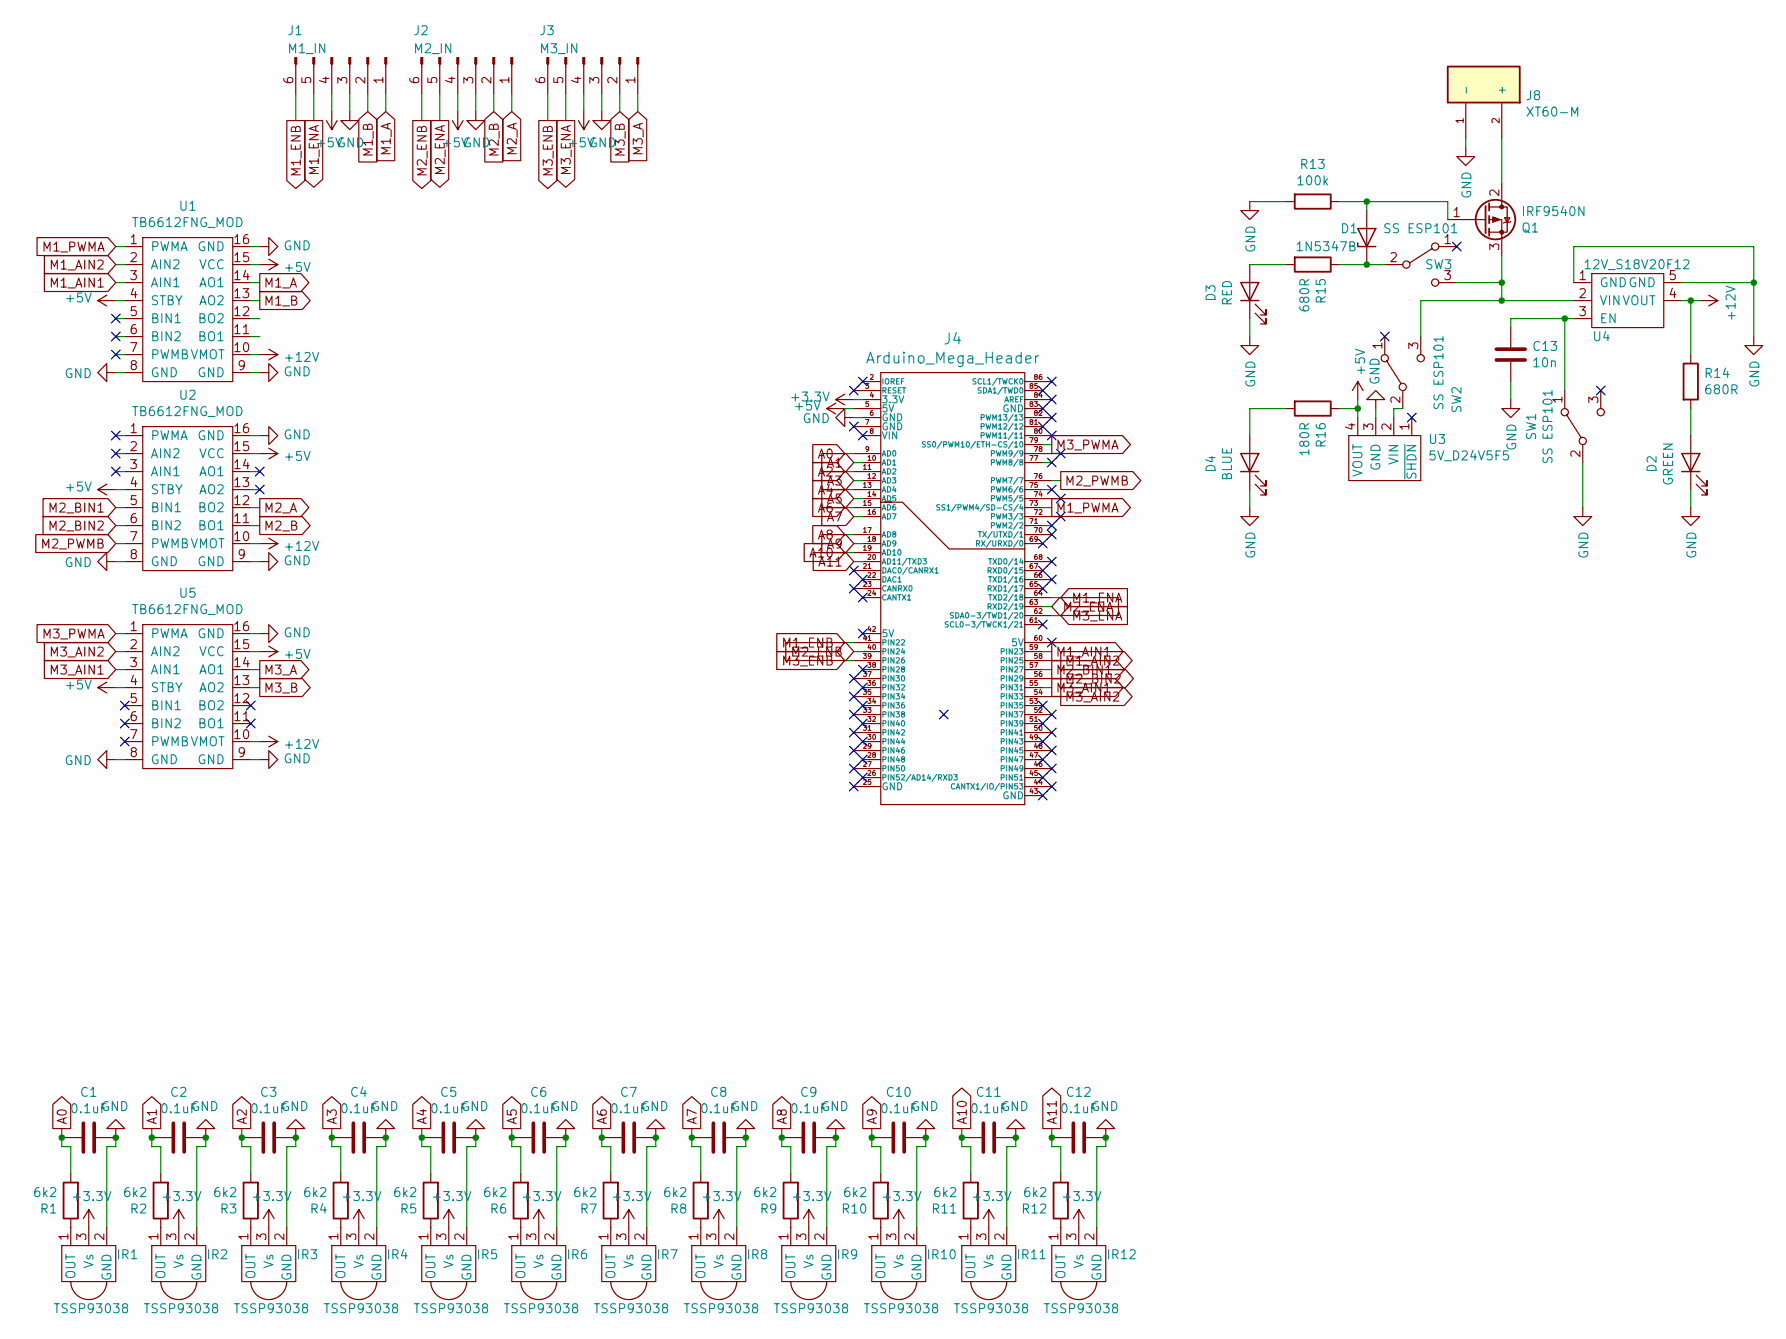
[picture p21: schematic Robocup_PCB.sch]

Parts:
C1, C2, C3, C4, C5, C6, C7, C8, C9, C10, C11, C12: 0.1uF; C_1206_3216Metric_Pad1.42x1.75mm_HandSolder
C13: 10n; C_1206_3216Metric_Pad1.42x1.75mm_HandSolder
D1: 1N5347B; D_DO-201_P15.24mm_Horizontal
D2: GREEN; LED_0805_2012Metric_Pad1.15x1.40mm_HandSolder
D3: RED; LED_0805_2012Metric_Pad1.15x1.40mm_HandSolder
D4: BLUE; LED_0805_2012Metric_Pad1.15x1.40mm_HandSolder
IR1, IR2, IR3, IR4, IR5, IR6, IR7, IR8, IR9, IR10, IR11, IR12: TSSP93038; IR_TSOP93038_TH
J1: M1_IN; PinSocket_1x06_P2.54mm_Vertical
J2: M2_IN; PinSocket_1x06_P2.54mm_Vertical
J3: M3_IN; PinSocket_1x06_P2.54mm_Vertical
J4: Arduino_Mega_Header; arduino_mega_header
J8: XT60-M; AMASS_XT60-M; PARTREV 1.2
Q1: IRF9540N; TO-263-2
R1, R2, R3, R4, R5, R6, R7, R8, R9, R10, R11, R12: 6k2; R_1206_3216Metric_Pad1.42x1.75mm_HandSolder
R13: 100k; R_1206_3216Metric_Pad1.42x1.75mm_HandSolder
R14, R15: 680R; R_1206_3216Metric_Pad1.42x1.75mm_HandSolder
R16: 180R; R_1206_3216Metric_Pad1.42x1.75mm_HandSolder
SW1, SW2, SW3: SS ESP101; PinSocket_1x03_P2.54mm_Vertical
U1, U2, U5: TB6612FNG_MOD; U_TB6612FNG_MOD
U3: 5V_D24V5F5
U4: 12V_S18V20F12; 12_S18V20F12_FP

Connections:
+3V3: IR1.3 (Vs), IR2.3 (Vs), IR3.3 (Vs), IR4.3 (Vs), IR5.3 (Vs), IR6.3 (Vs), IR7.3 (Vs), IR8.3 (Vs), IR9.3 (Vs), IR10.3 (Vs), IR11.3 (Vs), IR12.3 (Vs), J4.4 (3.3V)
+5V: J1.4, J2.4, J3.4, J4.5 (5V), R16.1, U1.4 (STBY), U1.15 (VCC), U2.4 (STBY), U2.15 (VCC), U3.4 (VOUT), U5.4 (STBY), U5.15 (VCC)
+12V: R14.1, U1.10 (VMOT), U2.10 (VMOT), U4.4 (VOUT), U5.10 (VMOT)
A0: C1.2, J4.9 (AD0), R1.2
A1: C2.2, J4.10 (AD1), R2.2
A2: C3.2, J4.11 (AD2), R3.2
A3: C4.2, J4.12 (AD3), R4.2
A4: C5.2, J4.13 (AD4), R5.2
A5: C6.2, J4.14 (AD5), R6.2
A6: C7.2, J4.15 (AD6), R7.2
A7: C8.2, J4.16 (AD7), R8.2
A8: C9.2, J4.17 (AD8), R9.2
A9: C10.2, J4.18 (AD9), R10.2
A10: C11.2, J4.19 (AD10), R11.2
A11: C12.2, J4.20 (AD11/TXD3), R12.2
GND: C1.1, C2.1, C3.1, C4.1, C5.1, C6.1, C7.1, C8.1, C9.1, C10.1, C11.1, C12.1, C13.2, D2.1 (K), D3.1 (K), D4.1 (K), IR1.2 (GND), IR2.2 (GND), IR3.2 (GND), IR4.2 (GND), IR5.2 (GND), IR6.2 (GND), IR7.2 (GND), IR8.2 (GND), IR9.2 (GND), IR10.2 (GND), IR11.2 (GND), IR12.2 (GND), J1.3, J2.3, J3.3, J4.6 (GND), J8.1 (-), R13.2, SW1.2 (B), U1.8 (GND), U1.9 (GND), U1.16 (GND), U2.8 (GND), U2.9 (GND), U2.16 (GND), U3.3 (GND), U4.1 (GND), U4.5 (GND), U5.8 (GND), U5.9 (GND), U5.16 (GND); also elsewhere on the board
M1_A: J1.1, U1.14 (AO1)
M1_AIN1: J4.59 (PIN23), U1.3 (AIN1)
M1_AIN2: J4.58 (PIN25), U1.2 (AIN2)
M1_B: J1.2, U1.13 (AO2)
M1_ENA: J1.5, J4.64 (TXD2/18)
M1_ENB: J1.6, J4.41 (PIN22)
M1_PWMA: J4.73 (SS1/PWM4/SD-CS/4), U1.1 (PWMA)
M2_A: J2.1, U2.12 (BO2)
M2_B: J2.2, U2.11 (BO1)
M2_BIN1: J4.57 (PIN27), U2.5 (BIN1)
M2_BIN2: J4.56 (PIN29), U2.6 (BIN2)
M2_ENA: J2.5, J4.63 (RXD2/19)
M2_ENB: J2.6, J4.40 (PIN24)
M2_PWMB: J4.76 (PWM7/7), U2.7 (PWMB)
M3_A: J3.1, U5.14 (AO1)
M3_AIN1: J4.55 (PIN31), U5.3 (AIN1)
M3_AIN2: J4.54 (PIN33), U5.2 (AIN2)
M3_B: J3.2, U5.13 (AO2)
M3_ENA: J3.5, J4.62 (SDA0-3/TWD1/20)
M3_ENB: J3.6, J4.39 (PIN26)
M3_PWMA: J4.79 (SS0/PWM10/ETH-CS/10), U5.1 (PWMA)
unnamed 37: C13.1, SW1.1 (A), U4.3 (EN); also elsewhere on the board
unnamed 38: D1.1 (K), R15.1, SW3.2 (B); also elsewhere on the board
unnamed: D1.2 (A), Q1.1 (G), R13.1
unnamed: D2.2 (A), R14.2
unnamed: D3.2 (A), R15.2
unnamed: D4.2 (A), R16.2
unnamed: IR1.1 (OUT), R1.1
unnamed: IR2.1 (OUT), R2.1
unnamed: IR3.1 (OUT), R3.1
unnamed: IR4.1 (OUT), R4.1
unnamed: IR5.1 (OUT), R5.1
unnamed: IR6.1 (OUT), R6.1
unnamed: IR7.1 (OUT), R7.1
unnamed: IR8.1 (OUT), R8.1
unnamed: IR9.1 (OUT), R9.1
unnamed: IR10.1 (OUT), R10.1
unnamed: IR11.1 (OUT), R11.1
unnamed: IR12.1 (OUT), R12.1
unnamed: J8.2 (+), Q1.2 (D)
unnamed 111: Q1.3 (S), SW2.3 (C), SW3.3 (C), U4.2 (VIN); also elsewhere on the board
unnamed 114: SW2.2 (B), U3.2 (VIN); also elsewhere on the board

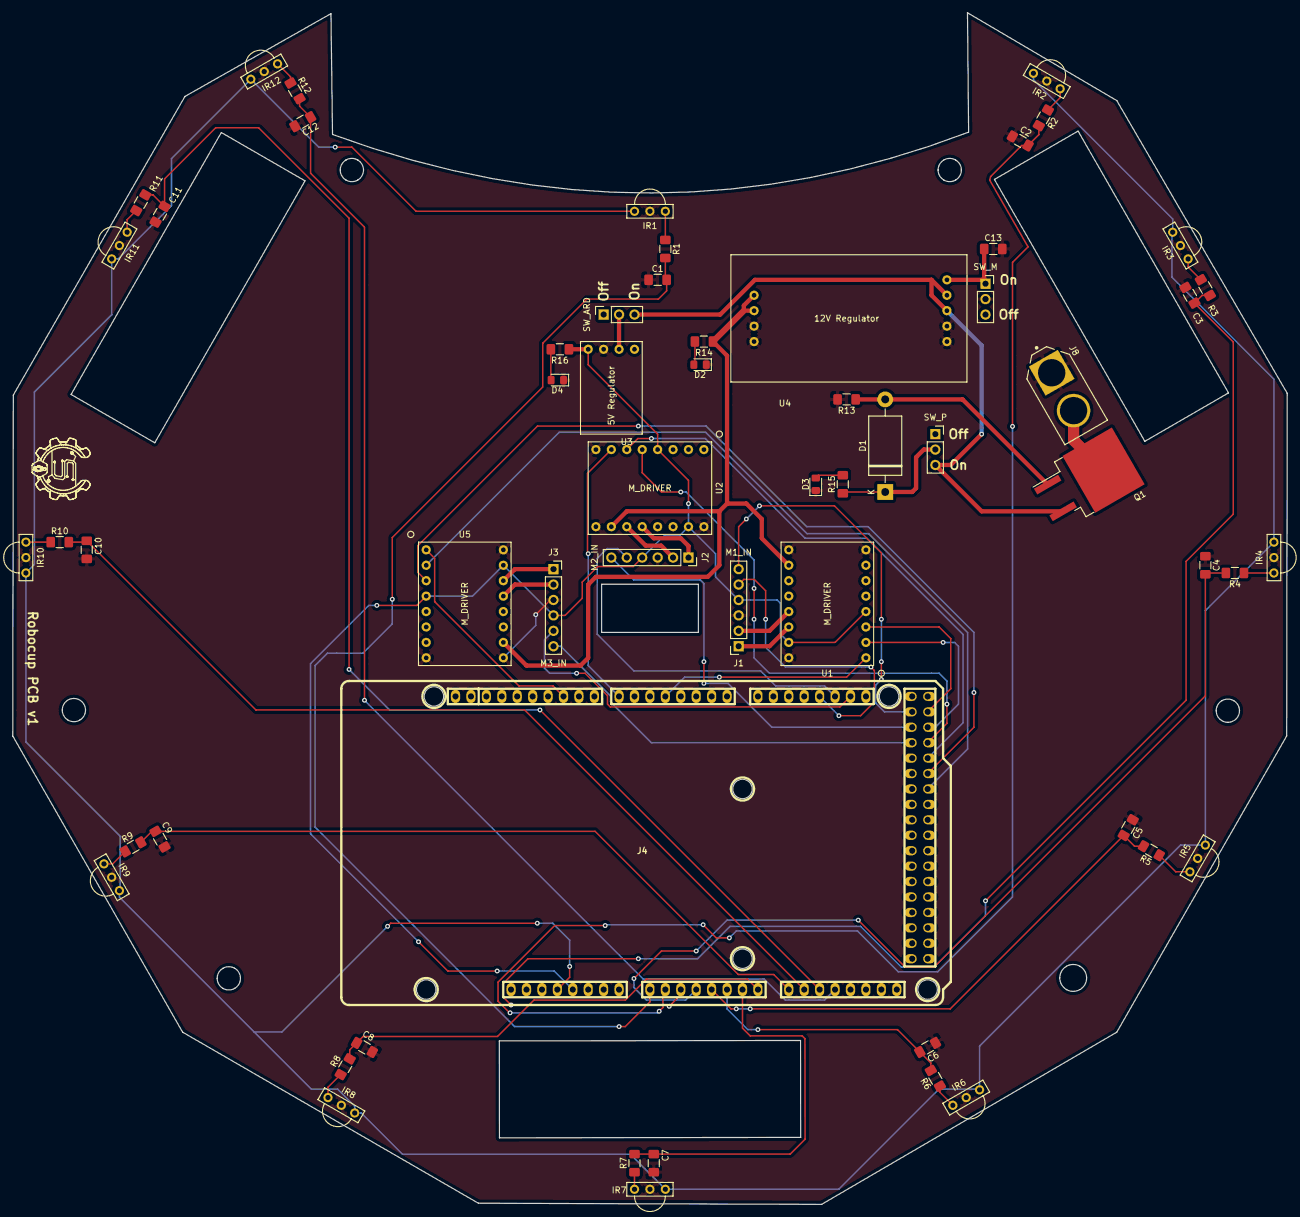
[picture p22: board Robocup_PCB.kicad_pcb from above]

Board: 2 copper layers, 209.8 x 196.2 mm, 59 parts (0 on the bottom side), 58 nets.

Other parts of the board:
SW_ARD: SS ESP101; PinSocket_1x03_P2.54mm_Vertical
SW_M: SS ESP101; PinSocket_1x03_P2.54mm_Vertical
SW_P: SS ESP101; PinSocket_1x03_P2.54mm_Vertical

Their connections:
GND: SW_M.2; also elsewhere on the board
unnamed 37: SW_M.1; also elsewhere on the board
unnamed 38: SW_P.2; also elsewhere on the board
unnamed 111: SW_ARD.3, SW_P.3; also elsewhere on the board
unnamed 114: SW_ARD.2; also elsewhere on the board
