Pixeljoch/Robocup_PCB/(commit log)

2021-01-03 first push
    [Robocup_PCB.kicad_pcb, Robocup_PCB.sch]
2021-01-07 Finished schematic, started PCB Design
    [IRFR120ZTRPBF.step, Robocup_PCB.sch, XT60-M.step]
2021-01-07 Redid power management, more efficient
    [Robocup_PCB.sch]
2021-01-08 Parts given Footprints
    [Robocup_PCB.sch]
2021-01-10 BOM list generated
    [Robocup_PCB.csv, Robocup_PCB.kicad_pcb]
2021-01-10 Finished PCB, Generated Gerbers
    [Robocup_PCB-B_Cu.gbr, Robocup_PCB-B_Mask.gbr, Robocup_PCB-B_Paste.gbr, Robocup_PCB-B_SilkS.gbr, Robocup_PCB-Edge_Cuts.gbr, Robocup_PCB-F_Cu.gbr, Robocup_PCB-F_Mask.gbr, Robocup_PCB-F_Paste.gbr]
2021-03-11 5V regulator done
    [Robocup_PCB.sch]
2021-04-08 Started Light PCB
    [Light_Ring_PCB.kicad_pcb, Light_Ring_PCB.sch, Robocup_PCB.sch]
2021-04-10 Started MUX
    [Robocup_PCB.sch]
2021-04-12 Finished MUX
    [Robocup_PCB.sch]
2021-04-14 Finished Motor Drivers
    [MOTORDRIVER.sch, Robocup_PCB.sch]
2021-04-15 Finished Light Ring Schematic
    [Light_Ring_PCB.sch, Robocup_PCB.sch]
2021-04-22 Started PCB
    [Light_Ring_PCB.kicad_pcb, voetbalrobotnieuwplaatv19.dxf]
2021-09-07 Finished LiPo balancer schematic
    [LiPo_12_Driver.kicad_pcb, LiPo_12_Driver.sch]
2021-10-20 Finished LIPO Driver
    [20A_Version.sch, 6A_Version.sch, LiPo_12_Driver.sch]
2021-10-22 Finished LIPO Schematic, started PCB design
    [20A_Version.sch, LiPo_12_Driver.kicad_pcb, LiPo_12_Driver.sch]
2021-10-22 more lipo pcb dev
    [20A_Version.sch, LiPo_12_Driver.kicad_pcb]
2021-10-26 More LIPO PCB development
    [LiPo_12_Driver.kicad_pcb]
2021-10-27 Almost finished LIPO PCB
    [LiPo_12_Driver.kicad_pcb]
2021-10-30 Finished LIPO Driver PCB
    [LiPo_12_Driver.kicad_pcb]
2021-10-30 Small updates, Ready for order
    [LiPo_12_Driver.kicad_pcb]
2021-10-31 Updated PCB because QFN package is out of stockaslhdflsakghlksa
    [20A_Version.sch, LiPo_12_Driver.kicad_pcb]
2021-11-05 LIPO gerbers generated
    [LiPo_12_Driver-B_Cu.gbl, LiPo_12_Driver-B_Mask.gbs, LiPo_12_Driver-B_Paste.gbp, LiPo_12_Driver-B_SilkS.gbo, LiPo_12_Driver-Edge_Cuts.gm1, LiPo_12_Driver-F_Cu.gtl, LiPo_12_Driver-F_Mask.gts, LiPo_12_Driver-F_Paste.gtp]
2021-11-09 Organized Files for Next PCBs
    [IRFR120ZTRPBF.step, IR_Board.kicad_pcb, IR_Board.sch, LiPo_12_Driver.kicad_pcb, MOTORDRIVER.sch, Main_Board.kicad_pcb, Main_Board.sch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]
2021-11-27 updated some stuff
    [20A_Version.sch]
2021-11-27 IR schematic complete
    [Main_Board.sch]
2021-12-23 Started Main Board
    [Main_Board.sch]
2022-01-10 Rounding up main and light board
    [Light_Ring_PCB.kicad_pcb, Light_Ring_PCB.sch, Main_Board.sch]
2022-01-14 Stuff with light
    [Main_Board.sch]
2022-01-14 motor drivers added
    [IR_Board.sch, Main_Board.sch]
2022-01-21 changed document settings
    [Main_Board.sch]
2022-01-21 Added all connectors, layout for pins
    [Main_Board.sch]
2022-01-25 old stuff
    [Robocup_PCB-B_Cu.gbl, Robocup_PCB-B_Mask.gbs, Robocup_PCB-B_Paste.gbp, Robocup_PCB-B_SilkS.gbo, Robocup_PCB-B_SilkS.gbr, Robocup_PCB-Edge_Cuts.gbr, Robocup_PCB-Edge_Cuts.gm1, Robocup_PCB-F_Cu.gbr]
2022-01-25 Started connecting main board
    [Main_Board.sch]
2022-01-26 started buck CC driver for LPCB
    [Light_Ring_PCB.sch, Main_Board.sch]
2022-01-28 Finished LightPCB
    [Light_Ring_PCB.kicad_pcb, Light_Ring_PCB.sch, Light_Ring_PCB.step]
2022-01-30 Finished Light PCB
    [LiPo_12_Driver-B_Cu.gbl, LiPo_12_Driver-B_Mask.gbs, LiPo_12_Driver-B_Paste.gbp, LiPo_12_Driver-B_SilkS.gbo, LiPo_12_Driver-Edge_Cuts.gm1, LiPo_12_Driver-F_Cu.gtl, LiPo_12_Driver-F_Mask.gts, LiPo_12_Driver-F_Paste.gtp]
2022-01-31 Finalizing Main PCB Sch
    [Light_Ring_PCB.sch, Main_Board.sch]
2022-02-01 Started Main PCB
2022-02-01 Finalized Pin layout, started redesigned Buck
    [IR_Board.sch, Light_Ring_PCB.kicad_pcb, Light_Ring_PCB.step, Main_Board.sch]
2022-02-03 added light gate
    [Main_Board.sch]
2022-02-04 Finished Main PCB schematic
    [Light_Ring_PCB.sch, Main_Board.sch]
2022-02-04 Some small alterations to the main pcb sch
    [Light_Ring_PCB.kicad_pcb, Light_Ring_PCB.sch, Main_Board.sch]
2022-02-05 Started Main PCB Drawing
    [Light_Ring_PCB.csv, Main PCB outline.dxf, Main_Board.kicad_pcb, Main_Board.sch]
2022-02-07 Finished Power Planes and layout, started drawing traces [MAIN BOARD]
    [Light_Ring_PCB.kicad_pcb, Light_Ring_PCB.sch, Main_Board.kicad_pcb, Main_Board.sch]
2022-02-07 Small changes to 12V connector [MAIN BOARD]
    [Main_Board.kicad_pcb, Main_Board.sch]
2022-02-08 Started actual traces [MAIN BOARD]
    [Light_Ring_PCB.kicad_pcb, Main_Board.kicad_pcb, Main_Board.sch]
2022-02-09 Finished main part traces [MAIN_PCB]
    [Light_Ring_PCB.kicad_pcb, Main_Board.kicad_pcb, Main_Board.sch]
2022-02-09 Finished board [MAIN BOARD]
    [Main_Board.kicad_pcb, Main_Board.sch]
2022-02-10 Finished DRC [MAIN BOARD]
    [Main_Board.kicad_pcb, Main_Board.sch]
2022-02-11 Started IR PCB
    [IR PCB outline final.dxf, IR_Board.kicad_pcb, IR_Board.sch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]
2022-02-13 Updated to Kicad 6
    [IR_Board.kicad_pcb, Light_Ring_PCB.kicad_pcb, Main_Board.kicad_pcb, Main_Board.kicad_sch]
2022-02-15 Progress with pcb [IR BOARD]
    [IR_Board.kicad_pcb, IR_Board.kicad_sch, Main_Board.kicad_pcb]
2022-02-15 Started drawing traces [IR BOARD]
    [IR_Board.kicad_pcb, IR_Board.kicad_sch]
2022-02-16 Continued drawing traces [IR BOARD]
    [IR_Board.kicad_pcb, IR_Board.kicad_sch]
2022-02-16 Finished IR, generated gerbers, ordered designs
    [IR_Board-B_Cu.gbl, IR_Board-B_Mask.gbs, IR_Board-B_Paste.gbp, IR_Board-B_Silkscreen.gbo, IR_Board-Edge_Cuts.gm1, IR_Board-F_Cu.gtl, IR_Board-F_Mask.gts, IR_Board-F_Paste.gtp]
2022-02-17 Changed .wrl to .step
    [IR_Board.kicad_pcb, IR_Board.step]
2022-03-08 made pdf for LIGHT PCB
    [Light_Ring_PCB.kicad_sch]
